eatkinso/bike-anti-theft-device/Firmware/ST/STM32Cube_FW_WL_V1.1.0/Projects/NUCLEO-WL55JC/Templates/DualCore/readme.txt

/**
  @page Templates  Description of the Templates example
  
  @verbatim
  ******************************************************************************
  * @file    Templates/DualCore/readme.txt 
  * @author  MCD Application Team
  * @brief   Description of the Templates example.
  ******************************************************************************
  *
  * Copyright (c) 2020 STMicroelectronics. All rights reserved.
  *
  * This software component is licensed by ST under BSD 3-Clause license,
  * the "License"; You may not use this file except in compliance with the
  * License. You may obtain a copy of the License at:
  *                       opensource.org/licenses/BSD-3-Clause
  *
  ******************************************************************************
  @endverbatim

@par Example Description

This projects provides a reference template that can be used to build any Dual Core (CM4 / CM0) firmware application.

This directory provides a reference template project that can be used to build any firmware application for
STM32WL55JCxx devices using STM32CubeWL HAL and running on NUCLEO-WL55JC board from STMicroelectronics. 

@note Care must be taken when using HAL_Delay(), this function provides accurate delay (in milliseconds)
      based on variable incremented in SysTick ISR. This implies that if HAL_Delay() is called from
      a peripheral ISR process, then the SysTick interrupt must have higher priority (numerically lower)
      than the peripheral interrupt. Otherwise the caller ISR process will be blocked.
      To change the SysTick interrupt priority you have to use HAL_NVIC_SetPriority() function.
      
@note The application needs to ensure that the SysTick time base is always set to 1 millisecond
      to have correct HAL operation.

@par Directory contents 

  - Templates/DualCore/Src/main.c                 Main program
  - Templates/DualCore/Src/system_stm32wlxx.c     STM32WLxx system clock configuration file
  - Templates/DualCore/Src/stm32wlxx_it.c         Interrupt handlers 
  - Templates/DualCore/Src/stm32wlxx_hal_msp.c    HAL MSP module
  - Templates/DualCore/Inc/main.h                 Main program header file  
  - Templates/DualCore/Inc/stm32wlxx_hal_conf.h   HAL Configuration file
  - Templates/DualCore/Inc/stm32wlxx_it.h         Interrupt handlers header file

@par Hardware and Software environment

  - This example runs on STM32WL55JCxx devices.
    
  - This example has been tested with STMicroelectronics NUCLEO-WL55JC
    boards and can be easily tailored to any other supported device 
    and development board.

@par How to use it ? 

In order to make the program work, you must do the following :
 - Open your preferred toolchain
 - Rebuild all files and load your image into target memory
 - Run the example

 * <h3><center>&copy; COPYRIGHT STMicroelectronics</center></h3>
 */
