eatkinso/bike-anti-theft-device/Firmware/ST/STM32Cube_FW_WL_V1.1.0/Projects/NUCLEO-WL55JC/Applications/LoRaWAN_FUOTA_DualCore/LoRaWAN_End_Node_DualCore/readme.txt

/**
  @page LoRaWAN_End_Node_DualCore Readme file

  @verbatim
  ******************** (C) COPYRIGHT 2020 STMicroelectronics *******************
  * @file    Applications/LoRaWAN_FUOTA_DualCore/LoRaWAN_End_Node_DualCore/readme.txt
  * @author  MCD Application Team
  * @brief   This application is a simple demo application software of a LoRa
  *          modem connecting to Network server. with firmware update over the air download capabilities
  ******************************************************************************
  * @attention
  *
  * <h2><center>&copy; Copyright (c) 2020 STMicroelectronics.
  * All rights reserved.</center></h2>
  *
  * This software component is licensed by ST under Ultimate Liberty license
  * SLA0044, the "License"; You may not use this file except in compliance with
  * the License. You may obtain a copy of the License at:
  *                             www.st.com/SLA0044
  *
  ******************************************************************************
  @endverbatim

@par Description

This directory contains a set of source files that implements a Dual Core (CM4 / CM0) LoRa application
device with firmware update over the air download capabilities.

For more details, refer to AN5554 "LoRaWAN firmware update over the air with STM32CubeWL" available from
the STMicroelectronics microcontroller website www.st.com.

This application is targeting the STM32WLxx Nucleo board embedding the STM32WLxx.
  ******************************************************************************

@par Keywords

Applications, SubGHz_Phy, LoRaWAN, End_Node, DualCore, FUOTA, SBSFU, KMS

@par Directory contents

  - LoRaWAN_End_Node_DualCore/CM0PLUS/Core/Inc/cmsis_nvic_virtual.h             Maps the NVIC functions on _SVC for Unpriviledge usage
  - LoRaWAN_End_Node_DualCore/CM0PLUS/Core/Inc/flash_if.h                       This file contains definitions for FLASH Interface functionalities.
  - LoRaWAN_End_Node_DualCore/CM0PLUS/Core/Inc/ipcc.h                           This file contains all the function prototypes for
                                                                                the ipcc.c file
  - LoRaWAN_End_Node_DualCore/CM0PLUS/Core/Inc/ipcc_if.h                        This file contains the interface of the ipcc driver on CM0PLUS.
  - LoRaWAN_End_Node_DualCore/CM0PLUS/Core/Inc/kms_if.h                         This file contains kms interfaces with middleware
  - LoRaWAN_End_Node_DualCore/CM0PLUS/Core/Inc/main.h                           : Header for main.c file.
                                                                                This file contains the common defines of the application.
  - LoRaWAN_End_Node_DualCore/CM0PLUS/Core/Inc/platform.h                       Header for General HW instances configuration
  - LoRaWAN_End_Node_DualCore/CM0PLUS/Core/Inc/rtc.h                            This file contains all the function prototypes for
                                                                                the rtc.c file
  - LoRaWAN_End_Node_DualCore/CM0PLUS/Core/Inc/stm32wlxx_hal_conf.h             HAL configuration file.
  - LoRaWAN_End_Node_DualCore/CM0PLUS/Core/Inc/stm32wlxx_it.h                   This file contains the headers of the interrupt handlers.
  - LoRaWAN_End_Node_DualCore/CM0PLUS/Core/Inc/stm32_lpm_if.h                   Header for Low Power Manager interface configuration
  - LoRaWAN_End_Node_DualCore/CM0PLUS/Core/Inc/subghz.h                         This file contains all the function prototypes for
                                                                                the subghz.c file
  - LoRaWAN_End_Node_DualCore/CM0PLUS/Core/Inc/sys_app.h                        Function prototypes for sys_app.c file
  - LoRaWAN_End_Node_DualCore/CM0PLUS/Core/Inc/sys_conf.h                       Applicative configuration, e.g. : debug, trace, low power, sensors
  - LoRaWAN_End_Node_DualCore/CM0PLUS/Core/Inc/sys_privileged_services.h        Maps sys_privileged_wrap functions on SVC and API to cortex services
  - LoRaWAN_End_Node_DualCore/CM0PLUS/Core/Inc/sys_privileged_wrap.h            This file contains all the function prototypes for
                                                                                the sys_privileged_wrap.c file
  - LoRaWAN_End_Node_DualCore/CM0PLUS/Core/Inc/timer_if.h                       configuration of the timer_if.c instances
  - LoRaWAN_End_Node_DualCore/CM0PLUS/Core/Inc/utilities_conf.h                 Header for configuration file to utilities
  - LoRaWAN_End_Node_DualCore/CM0PLUS/Core/Inc/utilities_def.h                  Definitions for modules requiring utilities
  - LoRaWAN_End_Node_DualCore/CM0PLUS/KMS/App/app_kms.h                         !!! No description found !!!
  - LoRaWAN_End_Node_DualCore/CM0PLUS/LoRaWAN/App/app_lorawan.h                 Header of application of the LRWAN Middleware
  - LoRaWAN_End_Node_DualCore/CM0PLUS/LoRaWAN/App/Commissioning.h               End-device commissioning parameters
  - LoRaWAN_End_Node_DualCore/CM0PLUS/LoRaWAN/App/fw_update_agent.h             This file provides set of functions to manage Firmware Update functionalities.
  - LoRaWAN_End_Node_DualCore/CM0PLUS/LoRaWAN/App/lora_app.h                    Header of application of the LRWAN Middleware
  - LoRaWAN_End_Node_DualCore/CM0PLUS/LoRaWAN/App/lora_app_version.h            Definition the version of the CM0PLUS application
  - LoRaWAN_End_Node_DualCore/CM0PLUS/LoRaWAN/App/se-identity.h                 Secure Element identity and keys
  - LoRaWAN_End_Node_DualCore/CM0PLUS/LoRaWAN/Target/frag_decoder_if.h          Applicative interfaces of LoRa-Alliance fragmentation decoder
  - LoRaWAN_End_Node_DualCore/CM0PLUS/LoRaWAN/Target/lorawan_conf.h             Header for LoRaWAN middleware instances
  - LoRaWAN_End_Node_DualCore/CM0PLUS/LoRaWAN/Target/mw_log_conf.h              Configure (enable/disable) traces for CM0
  - LoRaWAN_End_Node_DualCore/CM0PLUS/LoRaWAN/Target/radio_board_if.h           Header for Radio interface configuration
  - LoRaWAN_End_Node_DualCore/CM0PLUS/LoRaWAN/Target/radio_conf.h               Header of Radio configuration
  - LoRaWAN_End_Node_DualCore/CM0PLUS/LoRaWAN/Target/systime.h                  Map middleware systime
  - LoRaWAN_End_Node_DualCore/CM0PLUS/LoRaWAN/Target/timer.h                    Wrapper to timer server
  - LoRaWAN_End_Node_DualCore/CM0PLUS/MbMux/LmHandler_mbwrapper.h               This file implements the CM0PLUS side wrapper of the LmHandler
                                                                                interface shared between M0 and M4.
  - LoRaWAN_End_Node_DualCore/CM0PLUS/MbMux/mbmux.h                             API which interfaces CM0PLUS to IPCC
  - LoRaWAN_End_Node_DualCore/CM0PLUS/MbMux/mbmuxif_lora.h                      API provided to CM0PLUS application to register and handle LoraWAN via MBMUX
  - LoRaWAN_End_Node_DualCore/CM0PLUS/MbMux/mbmuxif_radio.h                     API for CM0PLUS application to register and handle RADIO driver via MBMUX
  - LoRaWAN_End_Node_DualCore/CM0PLUS/MbMux/mbmuxif_sys.h                       API for CM0PLUS application to handle the SYSTEM MBMUX channel
  - LoRaWAN_End_Node_DualCore/CM0PLUS/MbMux/mbmuxif_trace.h                     API for CM0PLUS application to register and handle TRACE via MBMUX
  - LoRaWAN_End_Node_DualCore/CM0PLUS/MbMux/radio_mbwrapper.h                   This file implements the CM0PLUS side wrapper of the Radio interface
                                                                                shared between M0 and M4.
  - LoRaWAN_End_Node_DualCore/CM4/Core/Inc/adc.h                                This file contains all the function prototypes for
                                                                                the adc.c file
  - LoRaWAN_End_Node_DualCore/CM4/Core/Inc/adc_if.h                             Header for ADC interface configuration
  - LoRaWAN_End_Node_DualCore/CM4/Core/Inc/dma.h                                This file contains all the function prototypes for
                                                                                the dma.c file
  - LoRaWAN_End_Node_DualCore/CM4/Core/Inc/ipcc.h                               This file contains all the function prototypes for
                                                                                the ipcc.c file
  - LoRaWAN_End_Node_DualCore/CM4/Core/Inc/ipcc_if.h                            This file contains the interface of the ipcc driver on CM4.
  - LoRaWAN_End_Node_DualCore/CM4/Core/Inc/main.h                               : Header for main.c file.
                                                                                This file contains the common defines of the application.
  - LoRaWAN_End_Node_DualCore/CM4/Core/Inc/platform.h                           Header for General HW instances configuration
  - LoRaWAN_End_Node_DualCore/CM4/Core/Inc/stm32wlxx_hal_conf.h                 HAL configuration file.
  - LoRaWAN_End_Node_DualCore/CM4/Core/Inc/stm32wlxx_it.h                       This file contains the headers of the interrupt handlers.
  - LoRaWAN_End_Node_DualCore/CM4/Core/Inc/stm32_lpm_if.h                       Header for Low Power Manager interface configuration
  - LoRaWAN_End_Node_DualCore/CM4/Core/Inc/sys_app.h                            Function prototypes for sys_app.c file
  - LoRaWAN_End_Node_DualCore/CM4/Core/Inc/sys_conf.h                           Applicative configuration, e.g. : debug, trace, low power, sensors
  - LoRaWAN_End_Node_DualCore/CM4/Core/Inc/sys_sensors.h                        Header for sensors application
  - LoRaWAN_End_Node_DualCore/CM4/Core/Inc/timer_if.h                           configuration of the timer_if.c instances
  - LoRaWAN_End_Node_DualCore/CM4/Core/Inc/usart.h                              This file contains all the function prototypes for
                                                                                the usart.c file
  - LoRaWAN_End_Node_DualCore/CM4/Core/Inc/usart_if.h                           Header for USART interface configuration
  - LoRaWAN_End_Node_DualCore/CM4/Core/Inc/utilities_conf.h                     Header for configuration file to utilities
  - LoRaWAN_End_Node_DualCore/CM4/Core/Inc/utilities_def.h                      Definitions for modules requiring utilities
  - LoRaWAN_End_Node_DualCore/CM4/LoRaWAN/App/app_lorawan.h                     Header of application of the LRWAN Middleware
  - LoRaWAN_End_Node_DualCore/CM4/LoRaWAN/App/CayenneLpp.h                      Implements the Cayenne Low Power Protocol
  - LoRaWAN_End_Node_DualCore/CM4/LoRaWAN/App/lora_app.h                        Header of application of the LRWAN Middleware
  - LoRaWAN_End_Node_DualCore/CM4/LoRaWAN/App/lora_app_version.h                Definition the version of the CM4 application
  - LoRaWAN_End_Node_DualCore/CM4/LoRaWAN/Target/lorawan_conf.h                 Header for LoRaWAN middleware instances
  - LoRaWAN_End_Node_DualCore/CM4/LoRaWAN/Target/systime.h                      Map middleware systime
  - LoRaWAN_End_Node_DualCore/CM4/LoRaWAN/Target/timer.h                        Wrapper to timer server
  - LoRaWAN_End_Node_DualCore/CM4/MbMux/LmHandler_mbwrapper.h                   This file implements the CM4 side wrapper of the LmHandler
                                                                                interface shared between M0 and M4.
  - LoRaWAN_End_Node_DualCore/CM4/MbMux/mbmux.h                                 API which interfaces CM4 to IPCC
  - LoRaWAN_End_Node_DualCore/CM4/MbMux/mbmuxif_lora.h                          API provided to CM4 application to register and handle LoraWAN via MBMUX
  - LoRaWAN_End_Node_DualCore/CM4/MbMux/mbmuxif_radio.h                         API for CM4 application to register and handle RADIO driver via MBMUX
  - LoRaWAN_End_Node_DualCore/CM4/MbMux/mbmuxif_sys.h                           API for CM4 application to handle the SYSTEM MBMUX channel
  - LoRaWAN_End_Node_DualCore/CM4/MbMux/mbmuxif_trace.h                         API for CM4 application to register and handle TRACE via MBMUX
  - LoRaWAN_End_Node_DualCore/CM4/MbMux/radio_mbwrapper.h                       This file implements the CM4 side wrapper of the Radio interface
                                                                                shared between M0 and M4.
  - LoRaWAN_End_Node_DualCore/Common/Board/stm32wlxx_nucleo_conf.h              STM32WLxx_Nucleo board configuration file.
  - LoRaWAN_End_Node_DualCore/Common/MbMux/features_info.h                      Feature list and parameters TypeDefinitions
  - LoRaWAN_End_Node_DualCore/Common/MbMux/lora_info.h                          To give info to the application about LoRaWAN configuration
  - LoRaWAN_End_Node_DualCore/Common/MbMux/mbmux_table.h                        Maps the IPCC channels to memory buffers
  - LoRaWAN_End_Node_DualCore/Common/MbMux/msg_id.h                             MBMUX message ID enumeration
  - LoRaWAN_End_Node_DualCore/Common/System/sys_debug.h                         Configuration of the debug.c instances

  - LoRaWAN_End_Node_DualCore/CM0PLUS/Core/Src/flash_if.c                       This file provides set of firmware functions to manage Flash
                                                                                Interface functionalities.
  - LoRaWAN_End_Node_DualCore/CM0PLUS/Core/Src/ipcc.c                           This file provides code for the configuration
                                                                                of the IPCC instances.
  - LoRaWAN_End_Node_DualCore/CM0PLUS/Core/Src/ipcc_if.c                        Interface to IPCC: handles IRQs and abstract application from Ipcc handler and channel direction
  - LoRaWAN_End_Node_DualCore/CM0PLUS/Core/Src/main.c                           : Main program body
  - LoRaWAN_End_Node_DualCore/CM0PLUS/Core/Src/rtc.c                            This file provides code for the configuration
                                                                                of the RTC instances.
  - LoRaWAN_End_Node_DualCore/CM0PLUS/Core/Src/stm32wlxx_hal_msp.c              This file provides code for the MSP Initialization
                                                                                and de-Initialization codes.
  - LoRaWAN_End_Node_DualCore/CM0PLUS/Core/Src/stm32wlxx_it.c                   Interrupt Service Routines.
  - LoRaWAN_End_Node_DualCore/CM0PLUS/Core/Src/stm32_lpm_if.c                   Low layer function to enter/exit low power modes (stop, sleep)
  - LoRaWAN_End_Node_DualCore/CM0PLUS/Core/Src/subghz.c                         This file provides code for the configuration
                                                                                of the SUBGHZ instances.
  - LoRaWAN_End_Node_DualCore/CM0PLUS/Core/Src/sys_app.c                        Initializes HW and SW system entities (not related to the radio)
  - LoRaWAN_End_Node_DualCore/CM0PLUS/Core/Src/sys_privileged_services.c        gives access to COrtex services like ThumbState, SVC, MPU
  - LoRaWAN_End_Node_DualCore/CM0PLUS/Core/Src/sys_privileged_wrap.c            Wrapper functions to call SVC when in Unprivilege mode
  - LoRaWAN_End_Node_DualCore/CM0PLUS/Core/Src/timer_if.c                       Configure RTC Alarm, Tick and Calendar manager
  - LoRaWAN_End_Node_DualCore/CM0PLUS/KMS/App/app_kms.c                         !!! No description found !!!
  - LoRaWAN_End_Node_DualCore/CM0PLUS/LoRaWAN/App/app_lorawan.c                 Application of the LRWAN Middleware
  - LoRaWAN_End_Node_DualCore/CM0PLUS/LoRaWAN/App/fw_update_agent.c             This file provides set of functions to manage Firmware Update functionalities.
  - LoRaWAN_End_Node_DualCore/CM0PLUS/LoRaWAN/App/lora_app.c                    Application of the LRWAN Middleware
  - LoRaWAN_End_Node_DualCore/CM0PLUS/LoRaWAN/Target/frag_decoder_if.c          Implements the Data Distribution Agent
  - LoRaWAN_End_Node_DualCore/CM0PLUS/LoRaWAN/Target/radio_board_if.c           This file provides an interface layer between MW and Radio Board
  - LoRaWAN_End_Node_DualCore/CM0PLUS/MbMux/features_info.c                     CM0PLUS supported features list
  - LoRaWAN_End_Node_DualCore/CM0PLUS/MbMux/LmHandler_mbwrapper.c               This file implements the CM0PLUS side wrapper of the LoraMac interface
                                                                                shared between M0 and M4.
  - LoRaWAN_End_Node_DualCore/CM0PLUS/MbMux/lora_info.c                         To give info to the application about LoRaWAN configuration
  - LoRaWAN_End_Node_DualCore/CM0PLUS/MbMux/mbmux.c                             Interface CPU2 to IPCC: multiplexer to map features to IPCC channels
  - LoRaWAN_End_Node_DualCore/CM0PLUS/MbMux/mbmuxif_lora.c                      allows CM0 application to register and handle LoraWAN to MBMUX
  - LoRaWAN_End_Node_DualCore/CM0PLUS/MbMux/mbmuxif_radio.c                     allows CM0PLUS application to register and handle RADIO driver via MBMUX
  - LoRaWAN_End_Node_DualCore/CM0PLUS/MbMux/mbmuxif_sys.c                       allows CM0 application to handle the SYSTEM MBMUX channel
  - LoRaWAN_End_Node_DualCore/CM0PLUS/MbMux/mbmuxif_trace.c                     Interface layer CM0PLUS Trace to MBMUX (Mailbox Multiplexer)
  - LoRaWAN_End_Node_DualCore/CM0PLUS/MbMux/radio_mbwrapper.c                   This file implements the CM0 side wrapper of the Radio interface
                                                                                shared between M0 and M4.
  - LoRaWAN_End_Node_DualCore/CM4/Core/Src/adc.c                                This file provides code for the configuration
                                                                                of the ADC instances.
  - LoRaWAN_End_Node_DualCore/CM4/Core/Src/adc_if.c                             Read status related to the chip (battery level, VREF, chip temperature)
  - LoRaWAN_End_Node_DualCore/CM4/Core/Src/dma.c                                This file provides code for the configuration
                                                                                of all the requested memory to memory DMA transfers.
  - LoRaWAN_End_Node_DualCore/CM4/Core/Src/ipcc.c                               This file provides code for the configuration
                                                                                of the IPCC instances.
  - LoRaWAN_End_Node_DualCore/CM4/Core/Src/ipcc_if.c                            Interface to IPCC: handles IRQs and abstract application from Ipcc handler and channel direction
  - LoRaWAN_End_Node_DualCore/CM4/Core/Src/main.c                               : Main program body
  - LoRaWAN_End_Node_DualCore/CM4/Core/Src/stm32wlxx_hal_msp.c                  This file provides code for the MSP Initialization
                                                                                and de-Initialization codes.
  - LoRaWAN_End_Node_DualCore/CM4/Core/Src/stm32wlxx_it.c                       Interrupt Service Routines.
  - LoRaWAN_End_Node_DualCore/CM4/Core/Src/stm32_lpm_if.c                       Low layer function to enter/exit low power modes (stop, sleep)
  - LoRaWAN_End_Node_DualCore/CM4/Core/Src/sys_app.c                            Initializes HW and SW system entities (not related to the radio)
  - LoRaWAN_End_Node_DualCore/CM4/Core/Src/sys_sensors.c                        Manages the sensors on the application
  - LoRaWAN_End_Node_DualCore/CM4/Core/Src/timer_if.c                           Configure RTC Alarm, Tick and Calendar manager
  - LoRaWAN_End_Node_DualCore/CM4/Core/Src/usart.c                              This file provides code for the configuration
                                                                                of the USART instances.
  - LoRaWAN_End_Node_DualCore/CM4/Core/Src/usart_if.c                           Configuration of UART driver interface for hyperterminal communication
  - LoRaWAN_End_Node_DualCore/CM4/LoRaWAN/App/app_lorawan.c                     Application of the LRWAN Middleware
  - LoRaWAN_End_Node_DualCore/CM4/LoRaWAN/App/CayenneLpp.c                      Implements the Cayenne Low Power Protocol
  - LoRaWAN_End_Node_DualCore/CM4/LoRaWAN/App/lora_app.c                        Application of the LRWAN Middleware
  - LoRaWAN_End_Node_DualCore/CM4/MbMux/LmHandler_mbwrapper.c                   This file implements the CM4 side wrapper of the LoraMac interface
                                                                                shared between M0 and M4.
  - LoRaWAN_End_Node_DualCore/CM4/MbMux/mbmux.c                                 CM4 side multiplexer to map features to IPCC channels
  - LoRaWAN_End_Node_DualCore/CM4/MbMux/mbmuxif_lora.c                          allows CM4 application to register and handle LoraWAN via MBMUX
  - LoRaWAN_End_Node_DualCore/CM4/MbMux/mbmuxif_radio.c                         allows CM4 application to register and handle RADIO driver via MBMUX
  - LoRaWAN_End_Node_DualCore/CM4/MbMux/mbmuxif_sys.c                           allows CM4 application to handle the SYSTEM MBMUX channel.
  - LoRaWAN_End_Node_DualCore/CM4/MbMux/mbmuxif_trace.c                         allows CM4 application to receive by CM0 TRACE via MBMUX
  - LoRaWAN_End_Node_DualCore/CM4/MbMux/radio_mbwrapper.c                       This file implements the CM4 side wrapper of the Radio interface
                                                                                shared between M0 and M4.
  - LoRaWAN_End_Node_DualCore/Common/System/system_stm32wlxx.c                  CMSIS Cortex Device Peripheral Access Layer System Source File
  - LoRaWAN_End_Node_DualCore/Common/System/sys_debug.c                         Enables 4 debug pins for internal signals RealTime debugging
  - LoRaWAN_End_Node_DualCore/STM32CubeIDE/CM0PLUS/Application/User/Core/syscalls.cSTM32CubeIDE Minimal System calls file
  - LoRaWAN_End_Node_DualCore/STM32CubeIDE/CM0PLUS/Application/User/Core/sysmem.cSTM32CubeIDE System Memory calls file
  - LoRaWAN_End_Node_DualCore/STM32CubeIDE/CM4/Application/User/Core/syscalls.c STM32CubeIDE Minimal System calls file
  - LoRaWAN_End_Node_DualCore/STM32CubeIDE/CM4/Application/User/Core/sysmem.c   STM32CubeIDE System Memory calls file

@par Hardware and Software environment

  - This example runs on the STM32WLxx Nucleo board.

  - STM32WLxx Nucleo board Set-up
    - Connect the Nucleo board to your PC with a USB cable type A to micro-B
      to ST-LINK connector.
    - Please ensure that the ST-LINK connector jumpers are fitted.

  - Configure the software via the configuration files:
    - CM0PLUS (Mw and radio drivers config)
        - sys_conf.h, radio_conf.h, lorawan_conf.h, Commissioning.h, se-identity.h, mw_log_conf.h, main.h, etc
    - CM4 (Lora application)
        - sys_conf.h, lora_app.h, nucleo_conf.h, main.h, etc
    - Careful:
        - the region and class chosen on CM4/LoRaWAN/App/lora_app.h shall be compatible with CM0PLUS/LoRaWAN/Target/lorawan_conf.h list

  -Set Up:

             --------------------------  V    V  --------------------------
             |      LoRa Object       |  |    |  |      LoRa Network      |
             |                        |  |    |  |                        |
   ComPort<--|                        |--|    |--|                        |-->Web Server
             |                        |          |                        |
             --------------------------          --------------------------

@par How to use it ?
In order to make the program work, you must do the following :
  - use the script \Scripts\<MyPreferredToolchain>\build.bat to rebuild the SBSFU and the LoRaWAN projects
  - use the script \Scripts\<MyPreferredToolchain>\program.bat to download the big binary on target device
  - Reset the system (two cores)
  - Run the example
  - Open a Terminal, connected the LoRa Object
  - UART Config = 115200, 8b, 1 stopbit, no parity, no flow control

@par How to debug ?
  - change or undefine following definitions in above files:
    - in ..\2_Images_SBSFU\CM0PLUS\app_sfu.h
      /*#define SFU_RDP_PROTECT_ENABLE*/
      /*#define SFU_C2SWDBG_PROTECT_ENABLE*/
    - in ..\2_Images_SBSFU\Common\app_sfu_common.h
      /*#define SFU_DAP_PROTECT_ENABLE*/
      /*#define SFU_C2_DDS_PROTECT_ENABLE*/
      #define SFU_HIDE_PROTECTION_CFG OB_SECURE_HIDE_PROTECTION_DISABLE
    - in .\LoRaWAN_End_Node_DualCore\CM4\Core\Inc\sys_conf.h
      #define DEBUGGER_ENABLED   1   to debug CM4
      #define LOW_POWER_DISABLE   1  at least on one MCU (CM4 or CM0PUS)
    - in .\LoRaWAN_End_Node_DualCore\CM0PLUS\Core\Inc\sys_conf.h
      #define DEBUGGER_ENABLED   1   to debug CM0PLUS
      #define LOW_POWER_DISABLE   1  at least on one MCU (CM4 or CM0PUS)
  - use the script \Scripts\<MyPreferredToolchain>\build.bat to rebuild the SBSFU and the LoRaWAN projects
  - use the script \Scripts\<MyPreferredToolchain>\program.bat to download the big binary on target device
  - unplug the USB and plug it back to reconnect the board to the PC
  - SBSFU run first then LoRaWAN_End_Node starts
  - LoRaWAN_End_Node CM4 code enters in while(1) loop waiting the push button BUTTON_SW2 to be pressed
  - the CM0PLUS code is in while(1) loop waiting the CM4 to set CPUS_BOOT_SYNC_ALLOW_CPU2_TO_START
  - if you need to debug CM4 open your preferred toolchain and select CM4 project and attach to running target
  - if you need to debug CM0PLUS open your preferred toolchain and select CM0PLUS project and attach to running target
  - set the breakpoints either in CM4 or CM0PLUS or both debugger instances
  - press the push button BUTTON_SW2:
     - CM4 exits its while(1) loop and executes MBMUXIF_SetCpusSynchroFlag(1) and reaches the CM4 breakpoint
     - this allows CM0PLUS to exit its while(1) loop and to reach the CM0PLUS breakpoint

 * <h3><center>&copy; COPYRIGHT STMicroelectronics</center></h3>
 */
