eatkinso/bike-anti-theft-device/Firmware/ST/STM32Cube_FW_WL_V1.1.0/Projects/NUCLEO-WL55JC/Examples/CORTEX/CORTEXM_ModePrivilege/readme.txt

    /**
  @page CORTEXM_ModePrivilege Cortex-M4 Mode Privilege example

  @verbatim
  ******************************************************************************
  * @file    CORTEX/CORTEXM_ModePrivilege/readme.txt
  * @author  MCD Application Team
  * @brief   Description of the Cortex-M4 Mode Privilege example.
  ******************************************************************************
  *
  * Copyright (c) 2020 STMicroelectronics. All rights reserved.
  *
  * This software component is licensed by ST under BSD 3-Clause license,
  * the "License"; You may not use this file except in compliance with the
  * License. You may obtain a copy of the License at:
  *                       opensource.org/licenses/BSD-3-Clause
  *
  ******************************************************************************
  @endverbatim

@par Example Description 

How to modify the Thread mode privilege access and stack. Thread mode is entered
on reset or when returning from an exception.

The associated program is used to:

1. Switch the Thread mode stack from Main stack to Process stack

2. Switch the Thread mode from Privileged to Unprivileged

3. Switch the Thread mode from Unprivileged back to Privileged

To monitor the stack used and the privileged or unprivileged access level of code
in Thread mode, a set of variables is available within the program. It is also
possible to use the 'Cortex register' window of the debugger.

LED2 Turns ON when the test is finished successfully.

@note Care must be taken when using HAL_Delay(), this function provides accurate delay (in milliseconds)
      based on variable incremented in SysTick ISR. This implies that if HAL_Delay() is called from
      a peripheral ISR process, then the SysTick interrupt must have higher priority (numerically lower)
      than the peripheral interrupt. Otherwise the caller ISR process will be blocked.
      To change the SysTick interrupt priority you have to use HAL_NVIC_SetPriority() function.
      
@note The application need to ensure that the SysTick time base is always set to 1 millisecond
      to have correct HAL operation.

@par Keywords

System, Cortex, Mode Privilege, Privileged access, thread mode, main stack, process stack

@par Directory contents 

  - CORTEX/CORTEXM_ModePrivilege/Inc/stm32wlxx_nucleo_conf.h     BSP configuration file
  - CORTEX/CORTEXM_ModePrivilege/Inc/stm32wlxx_hal_conf.h    HAL configuration file
  - CORTEX/CORTEXM_ModePrivilege/Inc/stm32wlxx_it.h          Interrupt handlers header file
  - CORTEX/CORTEXM_ModePrivilege/Inc/main.h                  Header for main.c module
  - CORTEX/CORTEXM_ModePrivilege/Src/stm32wlxx_it.c          Interrupt handlers
  - CORTEX/CORTEXM_ModePrivilege/Src//stm32wlxx_hal_msp.c     HAL MSP file
  - CORTEX/CORTEXM_ModePrivilege/Src/main.c                  Main program
  - CORTEX/CORTEXM_ModePrivilege/Src/system_stm32wlxx.c      STM32WLxx system source file

@par Hardware and Software environment

  - This example runs on STM32WL55JCIx devices.
    
  - This example has been tested with NUCLEO-WL55JC RevC board and can be
    easily tailored to any other supported device and development board.      

@par How to use it ? 
In order to make the program work, you must do the following :
- Open your preferred toolchain 
- Rebuild all files and load your image into target memory
- Run the example

 * <h3><center>&copy; COPYRIGHT STMicroelectronics</center></h3>
 */
