eatkinso/bike-anti-theft-device/Firmware/ST/STM32Cube_FW_WL_V1.1.0/Projects/NUCLEO-WL55JC/Examples/CRYP/CRYP_AESModes/readme.txt

/**
  @page CRYP_AESModes  Encrypt and Decrypt data using AES Algo in ECB/CBC/CTR
  chaining modes with all possible key sizes.
  
  @verbatim
  ******************************************************************************
  * @file    CRYP/CRYP_AESModes/readme.txt 
  * @author  MCD Application Team
  * @brief   Description of the CRYP AES Algorithm in all modes and all key sizes
             Example
  ******************************************************************************
  *
  * Copyright (c) 2020 STMicroelectronics. All rights reserved.
  *
  * This software component is licensed by ST under BSD 3-Clause license,
  * the "License"; You may not use this file except in compliance with the
  * License. You may obtain a copy of the License at:
  *                       opensource.org/licenses/BSD-3-Clause
  *
  ******************************************************************************
  @endverbatim

@par Example Description 

How to use the CRYP peripheral to encrypt and decrypt data using AES in chaining
modes (ECB, CBC, CTR).

In this example, the following key sizes are used: 128 or 256.

For this example, a firmware is used to interface with the Crypto peripheral
in polling mode.

This example behaves as follows:

1. ECB mode:
   - AES128 ECB encryption
   - AES256 ECB encryption
   - AES128 ECB decryption
   - AES256 ECB decryption
2. CBC mode:
   - AES128 CBC encryption
   - AES256 CBC encryption
   - AES128 CBC decryption
   - AES256 CBC decryption
3. CTR mode:
   - AES128 CTR encryption
   - AES256 CTR encryption
   - AES128 CTR decryption
   - AES256 CTR decryption

When resorting to IAR Embedded Workbench IDE, AES algorithms processing status
are displayed on debugger Terminal I/O as follows: View --> Terminal I/O.
When resorting to MDK-ARM KEIL IDE, AES algorithms processing status 
are displayed on debugger as follows:  View --> Serial Viewer --> Debug (printf) Viewer.
The following hardware modifications are required to display the data on debugger for MDK-ARM :
    - The solder bridge : SB8 should be closed
    - The solder bridge : SB31 should be opened
When resorting to STM32CubeIDE:
Command Code is displayed on debugger as follows: Window--> Show View--> Console.
In Debug configuration : 
- Window\Debugger, select the Debug probe : ST-LINK(OpenOCD)
- window\ Startup,add the command "monitor arm semihosting enable"

Results can be displayed on PC (through HyperTerminal or TeraTerm) by Virtual Com Port
in enabling USE_VCP_CONNECTION compilation switch and with the proper configuration
(115200 bauds, 8 bits data, 1 stop bit, no parity, no HW flow control).

When all ciphering and deciphering operations are successful, LED1 is turned on.
In case of ciphering or deciphering issue, LED3 is turned on. 

@par Keywords

Security, Cryptography, CRYPT, AES, ECB, CBC, CTR, MAC, USART

@par Directory contents 

  - CRYP/CRYP_AESModes/Inc/stm32wlxx_nucleo_conf.h     BSP configuration file
  - CRYP/CRYP_AESModes/Inc/stm32wlxx_hal_conf.h    HAL configuration file
  - CRYP/CRYP_AESModes/Inc/stm32wlxx_it.h          Interrupt handlers header file
  - CRYP/CRYP_AESModes/Inc/main.h                  Header for main.c module  
  - CRYP/CRYP_AESModes/Src/stm32wlxx_it.c          Interrupt handlers
  - CRYP/CRYP_AESModes/Src/main.c                  Main program
  - CRYP/CRYP_AESModes/Src/stm32wlxx_hal_msp.c     HAL MSP module
  - CRYP/CRYP_AESModes/Src/system_stm32wlxx.c      STM32WLxx system source file

@par Hardware and Software environment

@par How to use it ? 

In order to make the program work, you must do the following:
 - Open your preferred toolchain 
 - Rebuild all files and load your image into target memory
 - Run the example

 * <h3><center>&copy; COPYRIGHT STMicroelectronics</center></h3>
 */
