eatkinso/bike-anti-theft-device/Firmware/ST/STM32Cube_FW_WL_V1.1.0/Projects/NUCLEO-WL55JC/Examples/HAL/HAL_TimeBase/readme.txt

/**
  @page HAL_TimeBase HAL Time base example
  
  @verbatim
  ******************************************************************************
  * @file    HAL/HAL_TimeBase/readme.txt 
  * @author  MCD Application Team
  * @brief   Description of the HAL time base example.
  ******************************************************************************
  *
  * Copyright (c) 2020 STMicroelectronics. All rights reserved.
  *
  * This software component is licensed by ST under BSD 3-Clause license,
  * the "License"; You may not use this file except in compliance with the
  * License. You may obtain a copy of the License at:
  *                       opensource.org/licenses/BSD-3-Clause
  *
  ******************************************************************************
  @endverbatim

@par Example Description 

How to customize HAL using a general-purpose timer as main source of time base, 
instead of Systick.

In this example the used timer is TIM2.

Time base duration is kept unchanged: 1ms  since PPP_TIMEOUT_VALUEs are defined 
and handled in milliseconds basis.

The example brings, in user file, a new implementation of the following HAL weak functions:

HAL_InitTick() 
HAL_SuspendTick()
HAL_ResumeTick()

This implementation will overwrite native implementation from stm32wlxx_hal.c
and so user functions will be invoked instead when called.

The following time base functions are kept as implemented natively:

HAL_IncTick()
HAL_Delay()
HAL_IncTick()

When user pushes the User push-button (B1), the Tick increment is suspended if it is already
enabled, else it will be resumed.
In an infinite loop, LED2 toggles spaced out over 1s delay, except when tick increment is suspended.

@note Care must be taken when using HAL_Delay(), this function provides accurate delay (in milliseconds)
      based on variable incremented in TIM2 ISR. This implies that if HAL_Delay() is called from
      a peripheral ISR process, then the TIM2 interrupt must have higher priority (numerically lower)
      than the peripheral interrupt. Otherwise the caller ISR process will be blocked.
      To change the TIM2 interrupt priority you have to use HAL_NVIC_SetPriority() function.
      
@note The application need to ensure that the TIM2 time base is always set to 1 millisecond
      to have correct HAL operation.

@par Keywords

System, TIM, Time base, HAL

@par Directory contents

  - HAL/HAL_TimeBase/Inc/stm32wlxx_nucleo_conf.h     BSP configuration file
  - HAL/HAL_TimeBase/Inc/stm32wlxx_hal_conf.h    HAL configuration file
  - HAL/HAL_TimeBase/Inc/stm32wlxx_it.h          Interrupt handlers header file
  - HAL/HAL_TimeBase/Inc/stm32wlxx.h             Header for main.c module  
  - HAL/HAL_TimeBase/Src/stm32wlxx_it.c          Interrupt handlers
  - HAL/HAL_TimeBase/Src/stm32wlxx_hal_msp.c     HAL MSP file
  - HAL/HAL_TimeBase/Src/main.c                        Main program
  - HAL/HAL_TimeBase/Src/system_stm32wlxx.c      STM32WLxx system source file

@par Hardware and Software environment

  - This example runs on STM32WL55JCIx devices
    
  - This example has been tested with STMicroelectronics NUCLEO-WL55JC RevC board and can be
    easily tailored to any other supported device and development board.      

@par How to use it ? 

In order to make the program work, you must do the following :
 - Open your preferred toolchain 
 - Rebuild all files and load your image into target memory
 - Run the example 

 * <h3><center>&copy; COPYRIGHT STMicroelectronics</center></h3>
 */
