eatkinso/bike-anti-theft-device/Firmware/ST/STM32Cube_FW_WL_V1.1.0/Projects/NUCLEO-WL55JC/Examples/HAL/HAL_TimeBase_RTC_WKUP/readme.txt

/**
  @page HAL_TimeBase_RTC_WKUP HAL TimeBase RTC WakeUp
  
  @verbatim
  ******************************************************************************
  * @file    HAL/HAL_TimeBase_RTC_WAKUP/readme.txt 
  * @author  MCD Application Team
  * @brief   Description of the HAL TimeBase RTC WakeUp example.
  ******************************************************************************
  *
  * Copyright (c) 2020 STMicroelectronics. All rights reserved.
  *
  * This software component is licensed by ST under BSD 3-Clause license,
  * the "License"; You may not use this file except in compliance with the
  * License. You may obtain a copy of the License at:
  *                       opensource.org/licenses/BSD-3-Clause
  *
  ******************************************************************************
  @endverbatim

@par Example Description
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
