eatkinso/bike-anti-theft-device/Documentation/Demo_RVtable/block_diagram_final.png

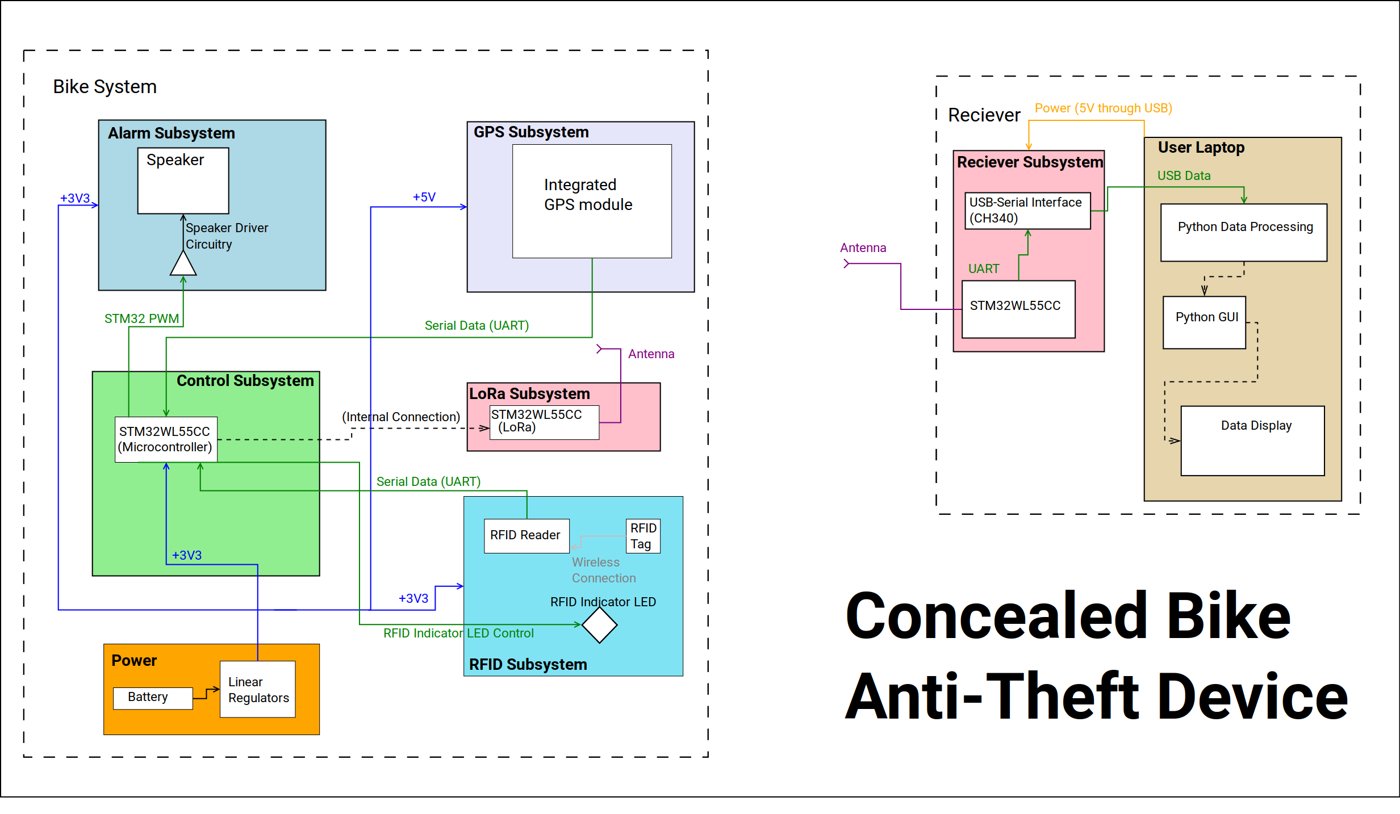
Documentation/Demo_RVtable/block_diagram_final.png
