eatkinso/bike-anti-theft-device/Documentation/Demo_RVtable/board_pic.jpeg

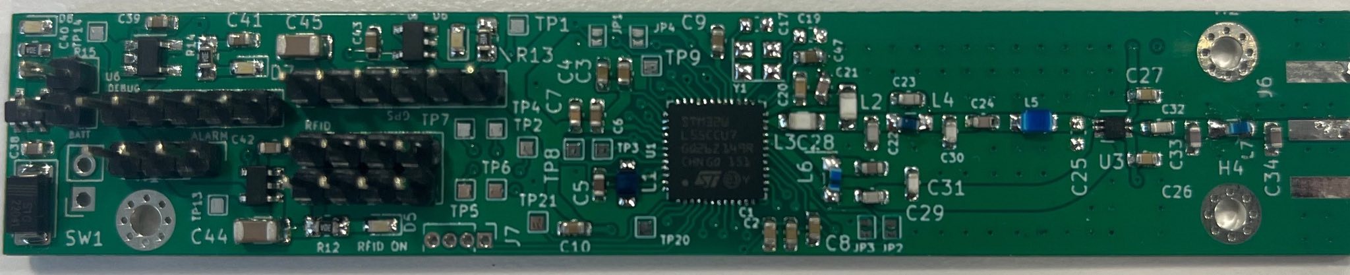
Documentation/Demo_RVtable/board_pic.jpeg
