eatkinso/bike-anti-theft-device/Documentation/Design Document/bike_reflector.jpg

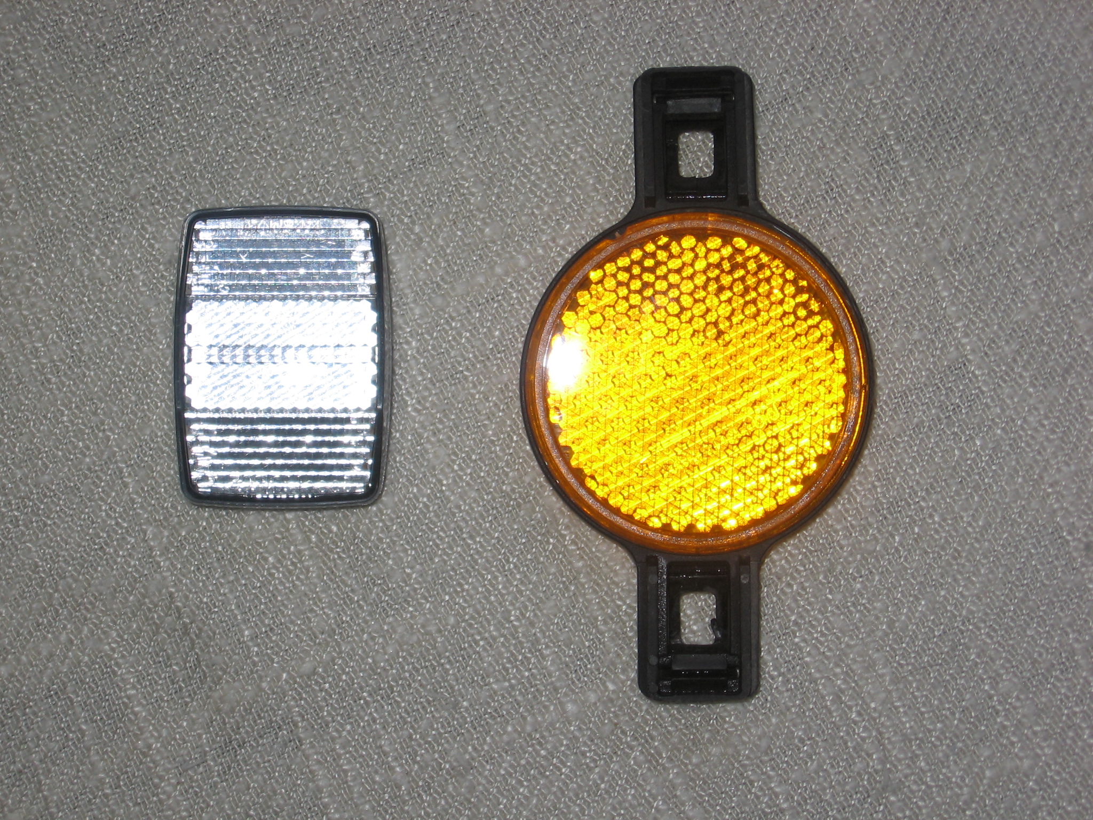
Documentation/Design Document/bike_reflector.jpg
