eatkinso/bike-anti-theft-device/Documentation/Design Document/block_diagram_full.png

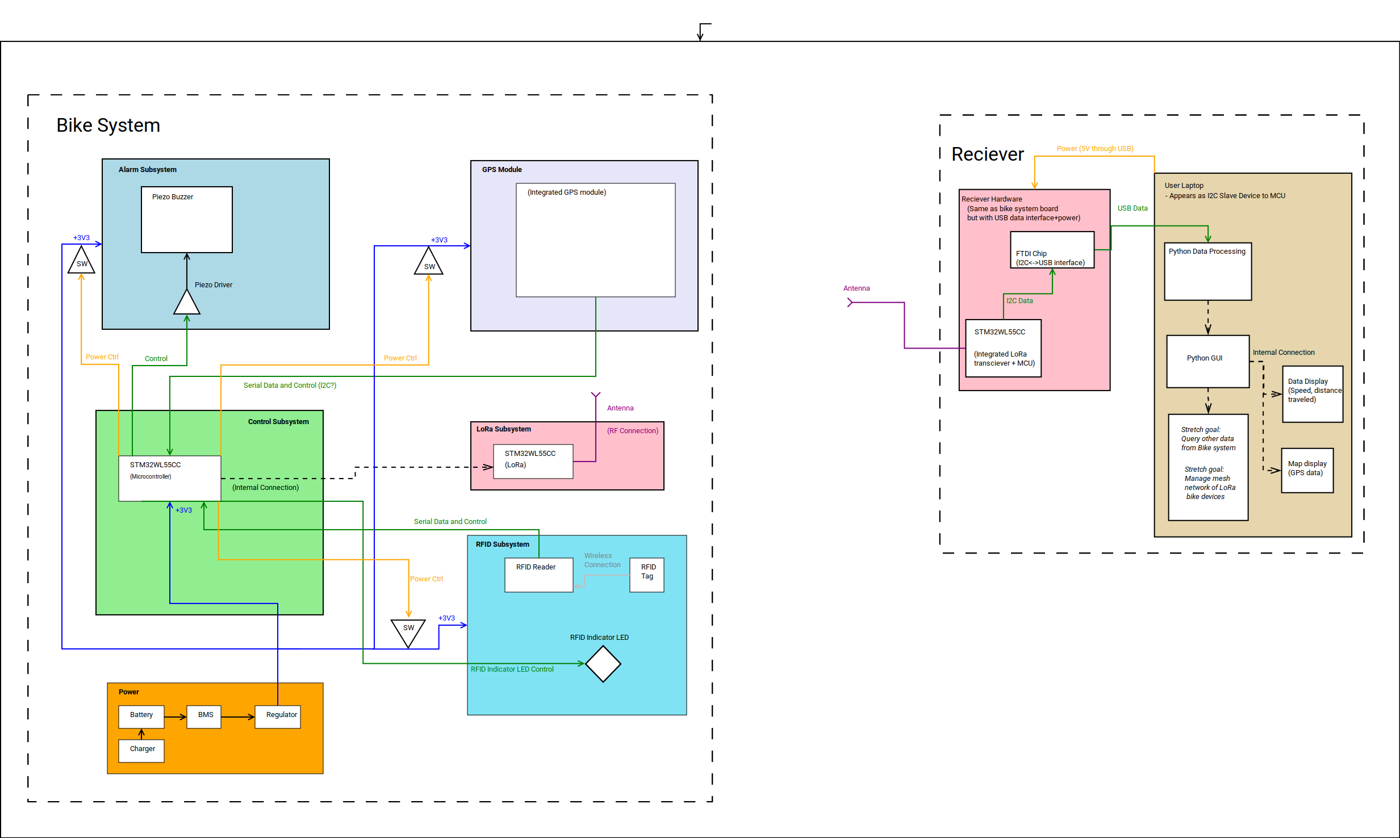
Documentation/Design Document/block_diagram_full.png
