eatkinso/bike-anti-theft-device/Documentation/Design Document/buzzer_ckt.png

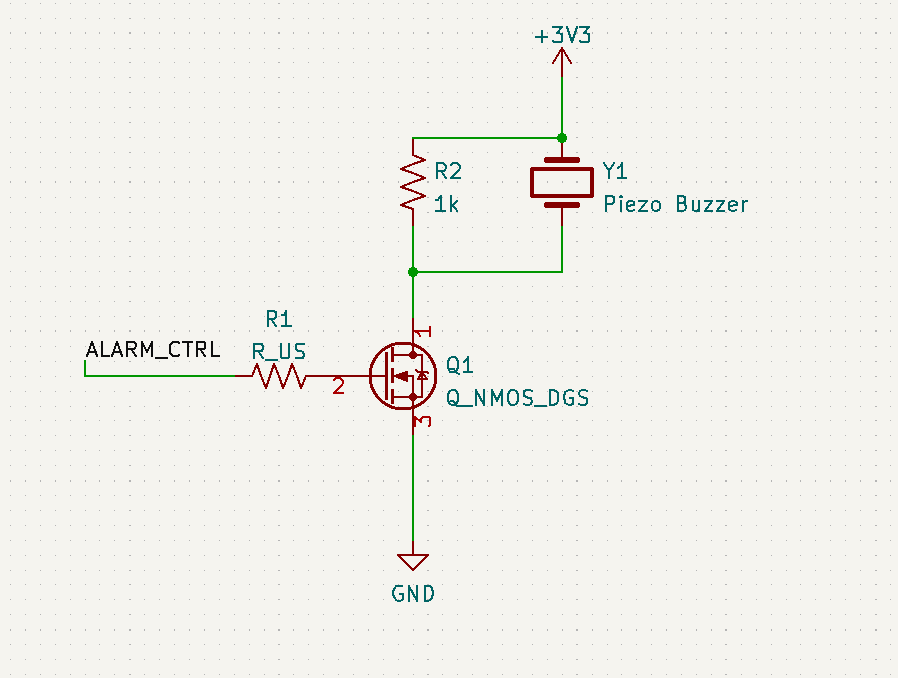
Documentation/Design Document/buzzer_ckt.png
