eatkinso/bike-anti-theft-device/Documentation/Design Document/linear_reg_diagram.png

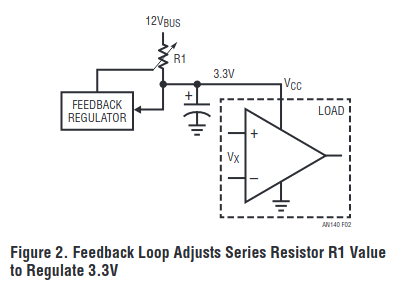
Documentation/Design Document/linear_reg_diagram.png
