eatkinso/bike-anti-theft-device/Documentation/Design Document/loadsw_sch.png

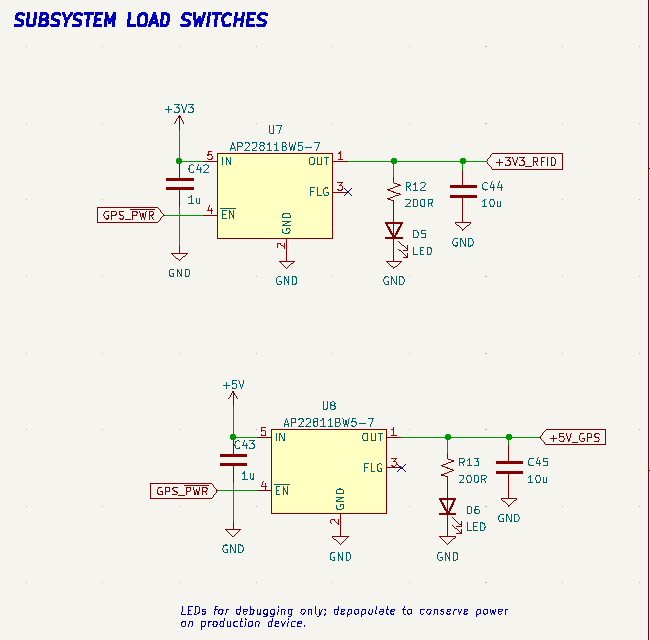
Documentation/Design Document/loadsw_sch.png
