eatkinso/bike-anti-theft-device/Documentation/Design Document/mcu_schematic.png

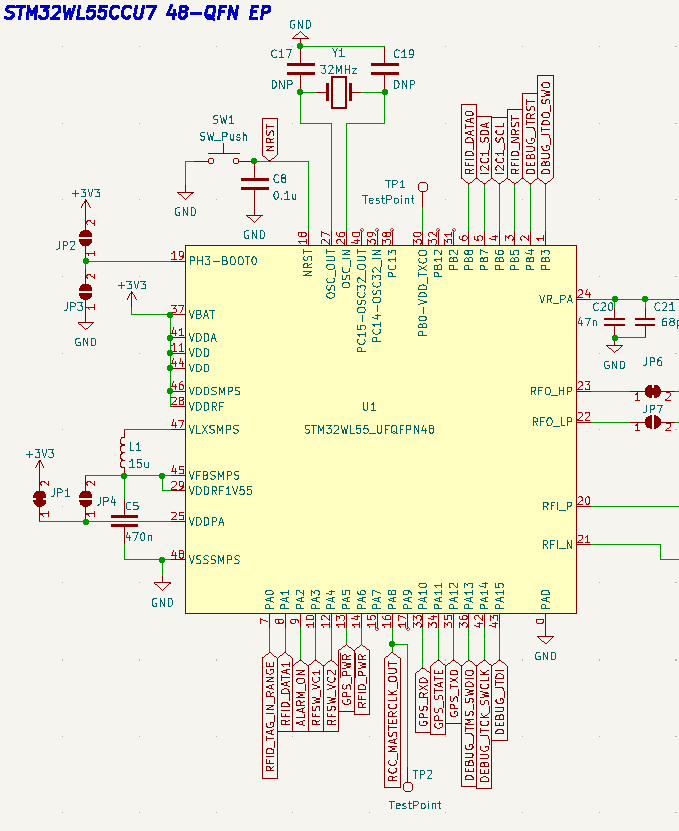
Documentation/Design Document/mcu_schematic.png
