eatkinso/bike-anti-theft-device/Documentation/Design Document/pwr_sch.png

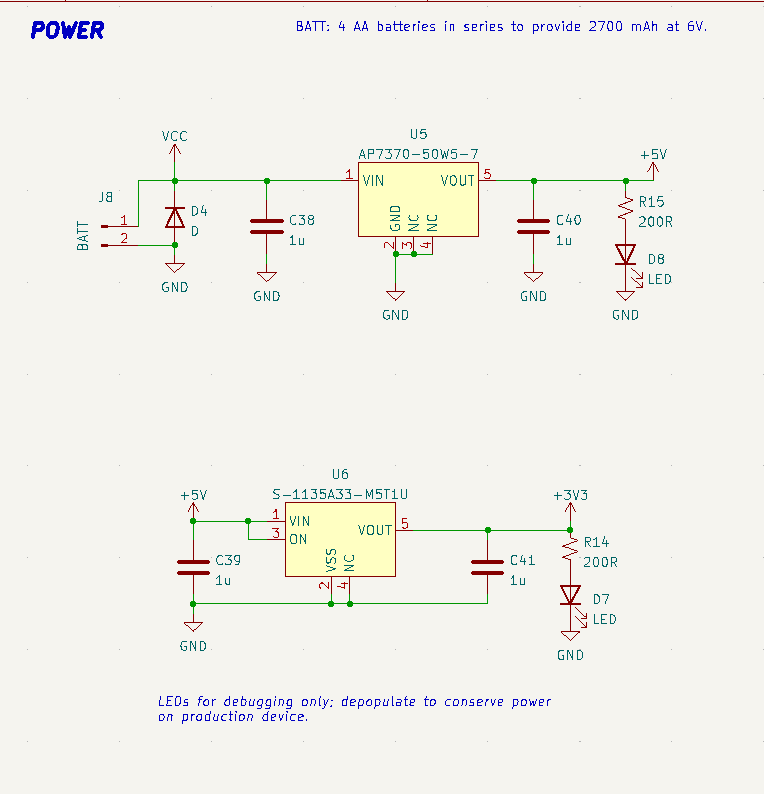
Documentation/Design Document/pwr_sch.png
