eatkinso/bike-anti-theft-device/Documentation/Design Document/rf-ckt.png

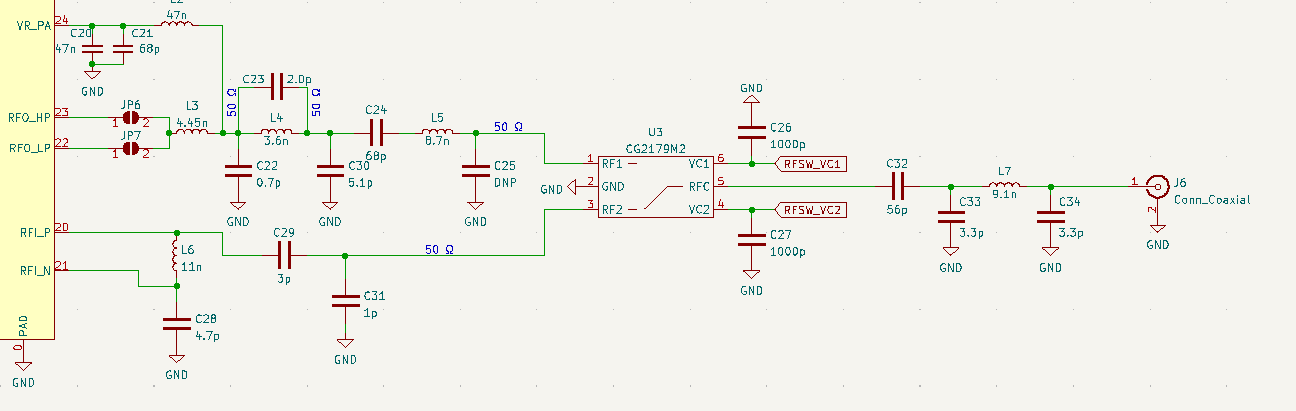
Documentation/Design Document/rf-ckt.png
