eatkinso/bike-anti-theft-device/Documentation/Design Document/rfid_sch.png

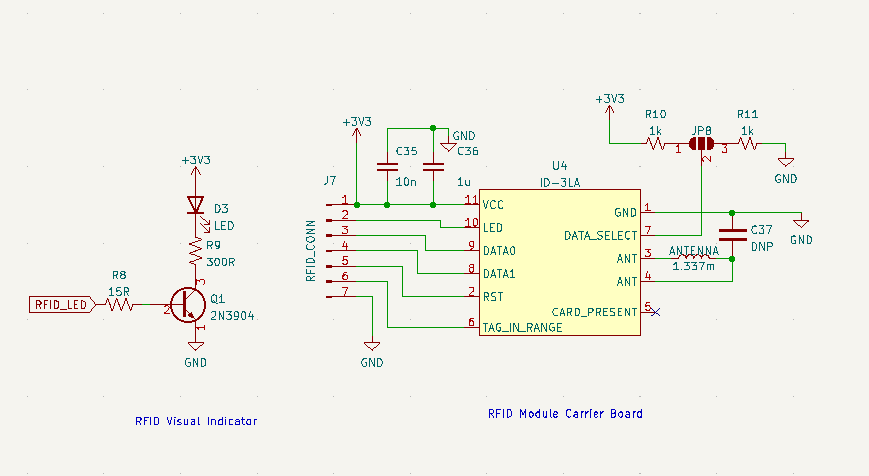
Documentation/Design Document/rfid_sch.png
