eatkinso/bike-anti-theft-device/Documentation/Design Document/usb_interface.png

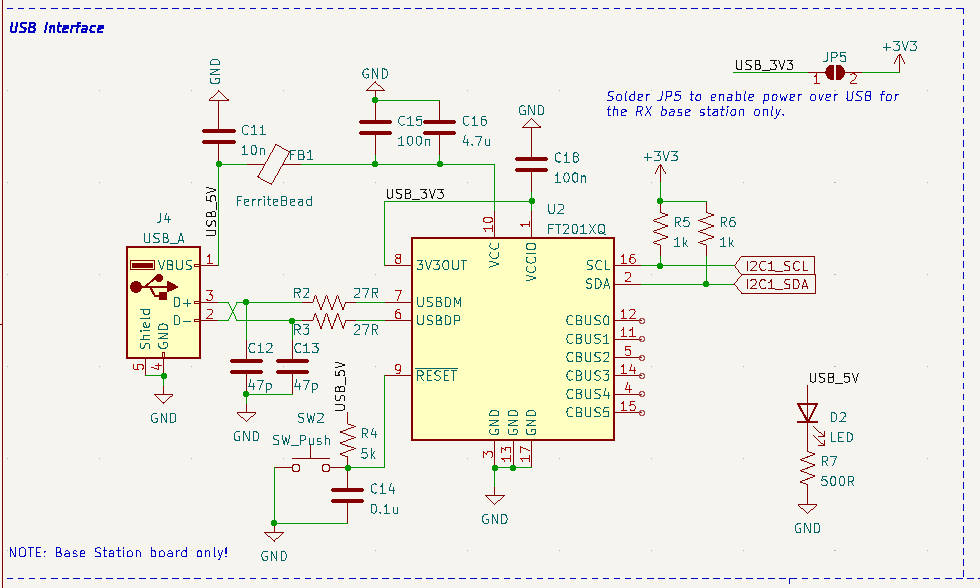
Documentation/Design Document/usb_interface.png
