eatkinso/bike-anti-theft-device/Documentation/Design Document/visual_aid.JPG

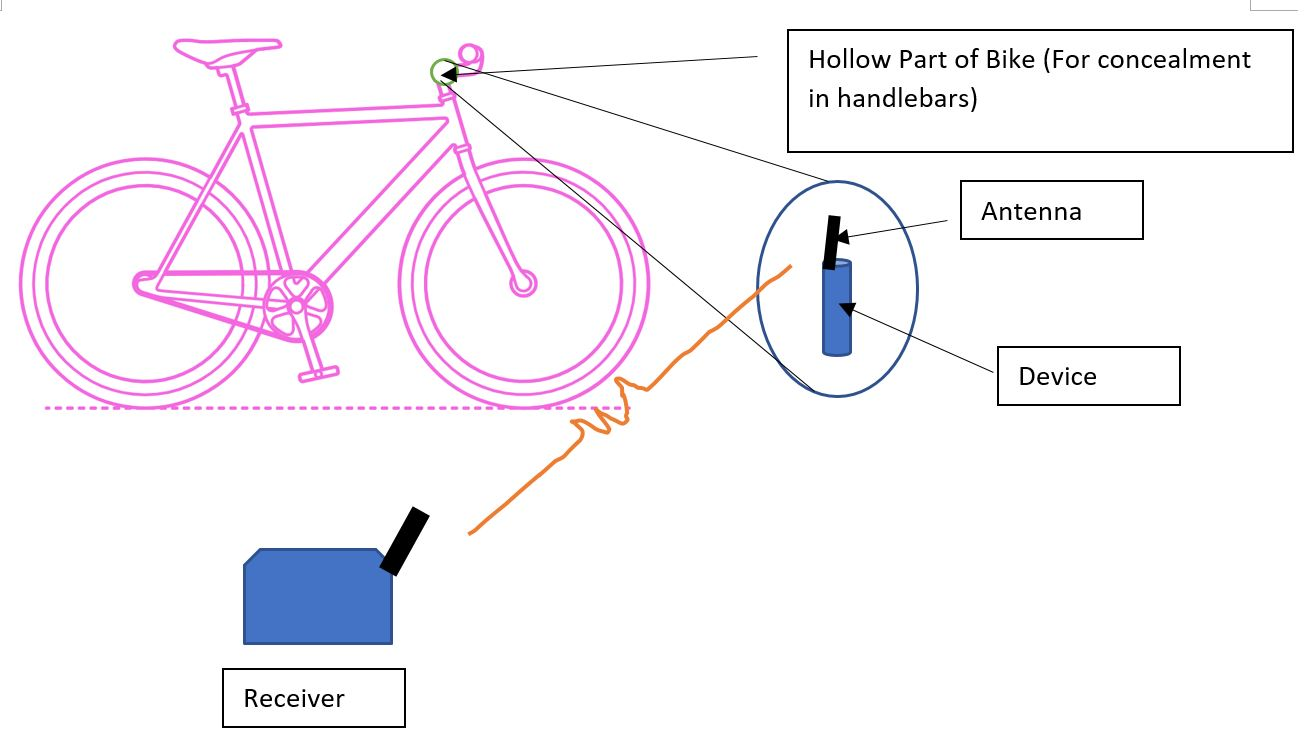
Documentation/Design Document/visual_aid.JPG
