eatkinso/bike-anti-theft-device/Documentation/Proposal/block_diagram_full.png

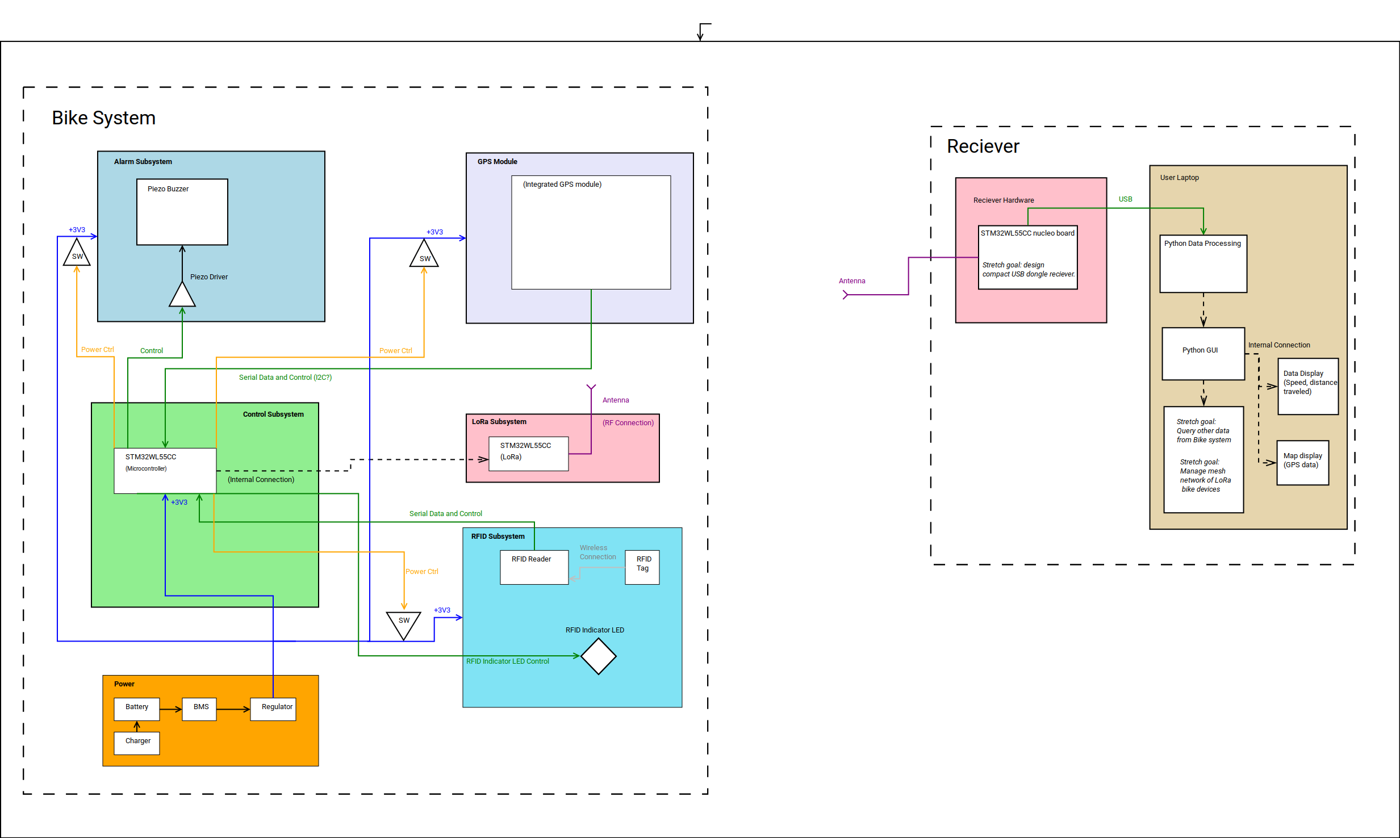
Documentation/Proposal/block_diagram_full.png
