eatkinso/bike-anti-theft-device/notebooks/Alex/data.png

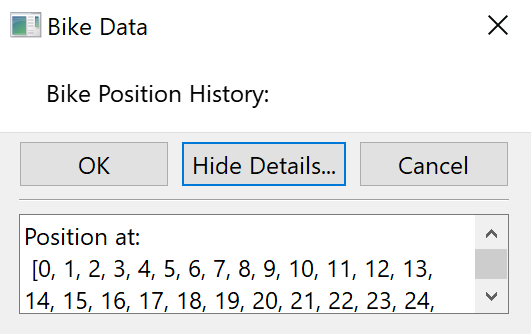
notebooks/Alex/data.png
