eatkinso/bike-anti-theft-device/notebooks/Alex/main.png

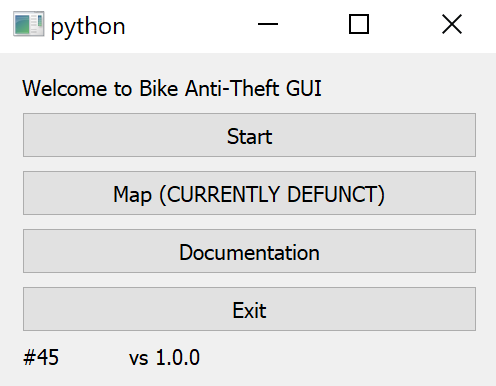
notebooks/Alex/main.png
