eatkinso/bike-anti-theft-device/notebooks/Elizabeth/f401pinout.png

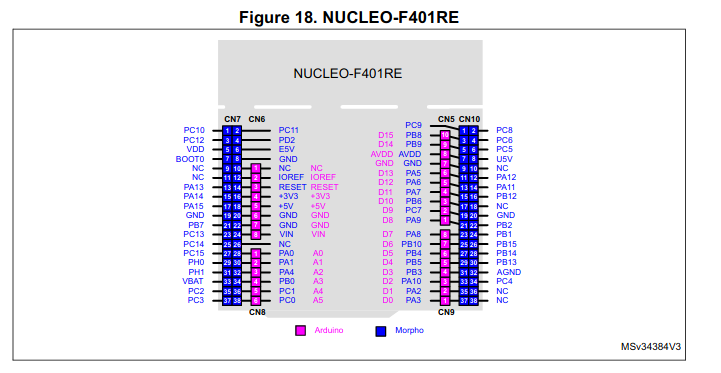
notebooks/Elizabeth/f401pinout.png
