eatkinso/bike-anti-theft-device/notebooks/Elizabeth/txnucleo.jpg

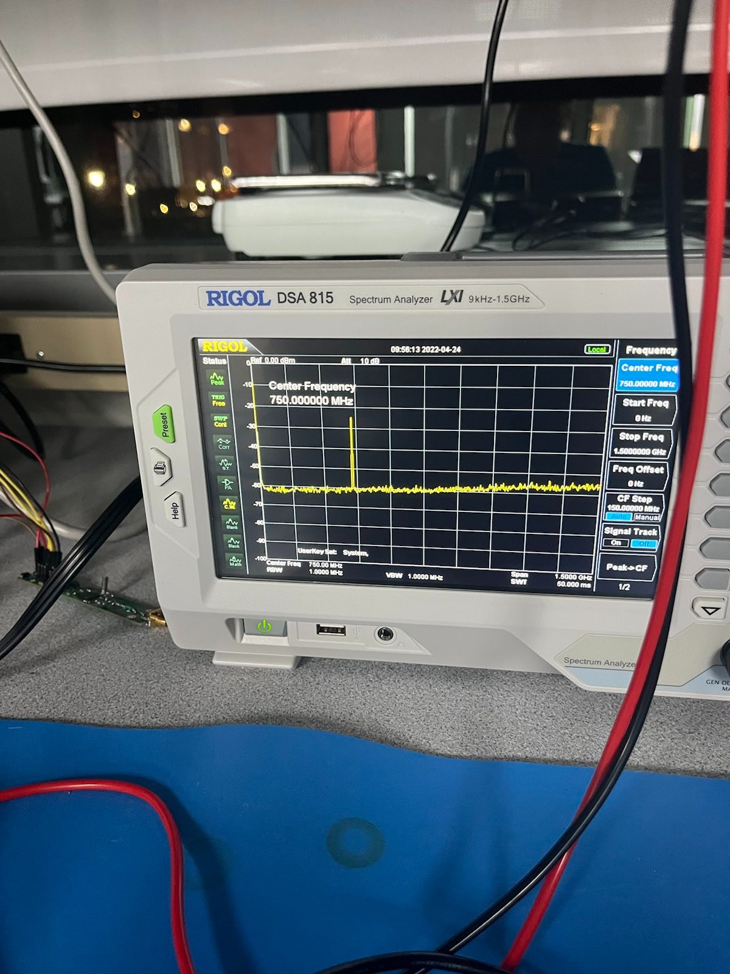
notebooks/Elizabeth/txnucleo.jpg
