eatkinso/bike-anti-theft-device/Hardware/bike_alarm/bike_alarm_materials.xlsx

Index | Quantity | Part Number | Manufacturer Part Number | Description | Customer Reference | Available | Backorder | Unit Price | Extended Price USD
1 | 5 | A106055CT-ND | CRG0805F10R | RES SMD 10 OHM 1% 1/8W 0805 | R1 | 5 | 0 | 0.1 | 0.50
2 | 5 | A119894CT-ND | RN73C2A1K0BTD | RES SMD 1K OHM 0.1% 1/10W 0805 | R2 | 5 | 0 | 0.78 | 3.90
3 | 5 | 609-3504-ND | 68000-403HLF | CONN HEADER VERT 3POS 2.54MM | J1 | 5 | 0 | 0.18 | 0.90
4 | 5 | 490-7709-ND | 7BB-12-9 | BUZZER ELEMENT STD 9KHZ 12MM | Y1 | 5 | 0 | 0.3 | 1.50
5 | 5 | 3757-PJA3404_R1_00001CT-ND | PJA3404_R1_00001 | SOT-23, MOSFET | Q1 | 5 | 0 | 0.38 | 1.90
