eatkinso/bike-anti-theft-device/Hardware/STrefboards/en.STM32WL_Reference_Board_MB1720-XO_IOs_Shield/Manufacturing/3.1. BOM/BOM/STM32WL_UFQFPN48_Reference_Design_+14dBm_433MHz.xlsx

Designator | Description | Package | Manufacturer | Manufacturer_Part_Number | Quantity | Internal_Part_Number
C1, C6, C10, C35 | Capacitor, MLCC, 4.7uF, 16V, X5R, 10%, 0603, T=0.8mm | C0603 | YAGEO | CC0603KRX5R7BB475 | 4
C2, C3, C4, C5, C7, C11, C12 | Capacitor, MLCC, 100nF, 16V, X7R, 10%, 0402, T=0,5mm | C0402 | YAGEO | CC0402KRX7R7BB104 | 7
C8, C9 | Capacitor, MLCC, 5.1 pF, 50V, NPO, +-0.1pF, 0402, T=0.5mm |  | YAGEO | CC0402CRNPO9BN5R1 | 2
C13, C23 | Capacitor, MLCC, 1nF, 16V, X7R, 10%, 0402, T=0.5mm |  | YAGEO | CC0402KRX7R7BB102 | 2
C14 | Capacitor, MLCC, 4.7 uF, 16V, X5R, 10%, 0603, T=0.8mm | C0603 | YAGEO | CC0603KRX5R7BB474 | 1
C15, C18, C20, C26, C27, C28, C29, C31, SB4, SB5, SB7, SB9 | [NoValue], RF Capacitor, Capacitor, MLCC, 6.8pF, 50V, NPO, +-0.1pF, 0402, T=0.5mm, Solder Bridge Open [0402] (Unpopulated) | [NoParam], C0402 |  |  | 12
C17 | RF Capacitor |  | MURATA | GJM1555C1H5R1CB01 | 1
C19, C25 | RF Capacitor |  | [NoValue], MURATA | GRM1555C1E680JA01 | 2
C21 | RF Capacitor |  | MURATA | GJM1555C1H220GB01 | 1
C22 | RF Capacitor |  | MURATA | GJM1555C1H100GB01 | 1
C24, C30 | RF Capacitor |  | MURATA | GJM1555C1H4R7WB01 | 2
C32, C33, C34 | Capacitor, MLCC, 33pF, 50V, NPO, 2%, 0402, T=0,5mm |  | MURATA | GJM1555C1H330GB01D | 3
C36, C37 | 10pF ±1% 50V Ceramic Capacitor C0G, NP0 0402 (1005 Metric) |  | MURATA | GJM1555C1H100FB01D | 2
CN1, CN2 | Connector right-angle, pitch 2.54mm, 20 contacts |  | SAMTEC | TSW-120-07-L-S | 2
J1, J2 | Header 1x2 Through hole 2.54mm |  | MOLEX | 22-03-2021 | 2
J4 | SMA Jack, Edge Mount, 50 Ohms |  | SAMTEC | SMA-J-P-H-ST-EM1 | 1
L1 | SMD Chip ferrite bead, 600R@100MHz +/-25%, 350mA, 500mohm DC, 0603, T=0.8mm |  | TAI-TECH | FCM1608KF-601T03 | 1
L2 | MLZ2012 Multilayer Shielded Inductor 15µH, ±5% |  | TDK | MLZ2012M150W | 1
L3 | RF Inductor |  |  | LQW15AN56NG00 | 1
L4 |  |  | MURATA | LQW15AN5N6C10 | 1
L5 | RF Inductor |  | MURATA | LQW15AN16NG00 | 1
L6, L7, SB1, SB2, SB3, SB6, SB8, SB11, SB13, SB14 | Zero ohm resistor, Solder Bridge 0R [0402] (Populated with 0 Ohm) |  | Vishay / Dale, [NoValue] | RCS04020000Z0ED | 10
L8 | RF Inductor |  | MURATA | LQW15AN39NG00 | 1
R1 | Resistor,10K,0603,1%,1/10W |  | YAGEO | RC0603FR-0710KL | 1
R2, R3 | Resistor,100R,0402,1%,1/16W |  | YAGEO | RC0402FR-07100RL | 2
RF BoM, SB10 | [NoValue], Solder Bridge |  |  |  | 2
S1 | RF Shield Frame + Cover without apertures |  | Masach Tech | MS409-10 | 1
U2 | ESD protection 6V1 |  | STMICROELECTRONICS | ESDALC6V1-1U2 | 1
U3 | DC switch - Ultra-Low SPDT analog switch |  | INFINEON | BGS12SN6 | 1
U4 | HQDC : Verified April, 25 2019 |  | STMicroelectronics | STM32WLxxxx | 1
X1 | Crystal 32.768kHz, 6pF, -+20PPM, R=80K, SMD |  | NDK | NX2012SA 32.768KHz EXS00A-MU00527 | 1
X2 | Crystal 32 MHz, 8pF, -+10 PPM, R=60Ω, SMD |  | NDK | NX2016SA 32MHz EXS00A-CS06465 | 1
