eatkinso/bike-anti-theft-device/Hardware/STrefboards/MB1552B/STM32WL_UFQFPN48_REF_BOARD_High_Power_High_Band_868-915MHz.PDF

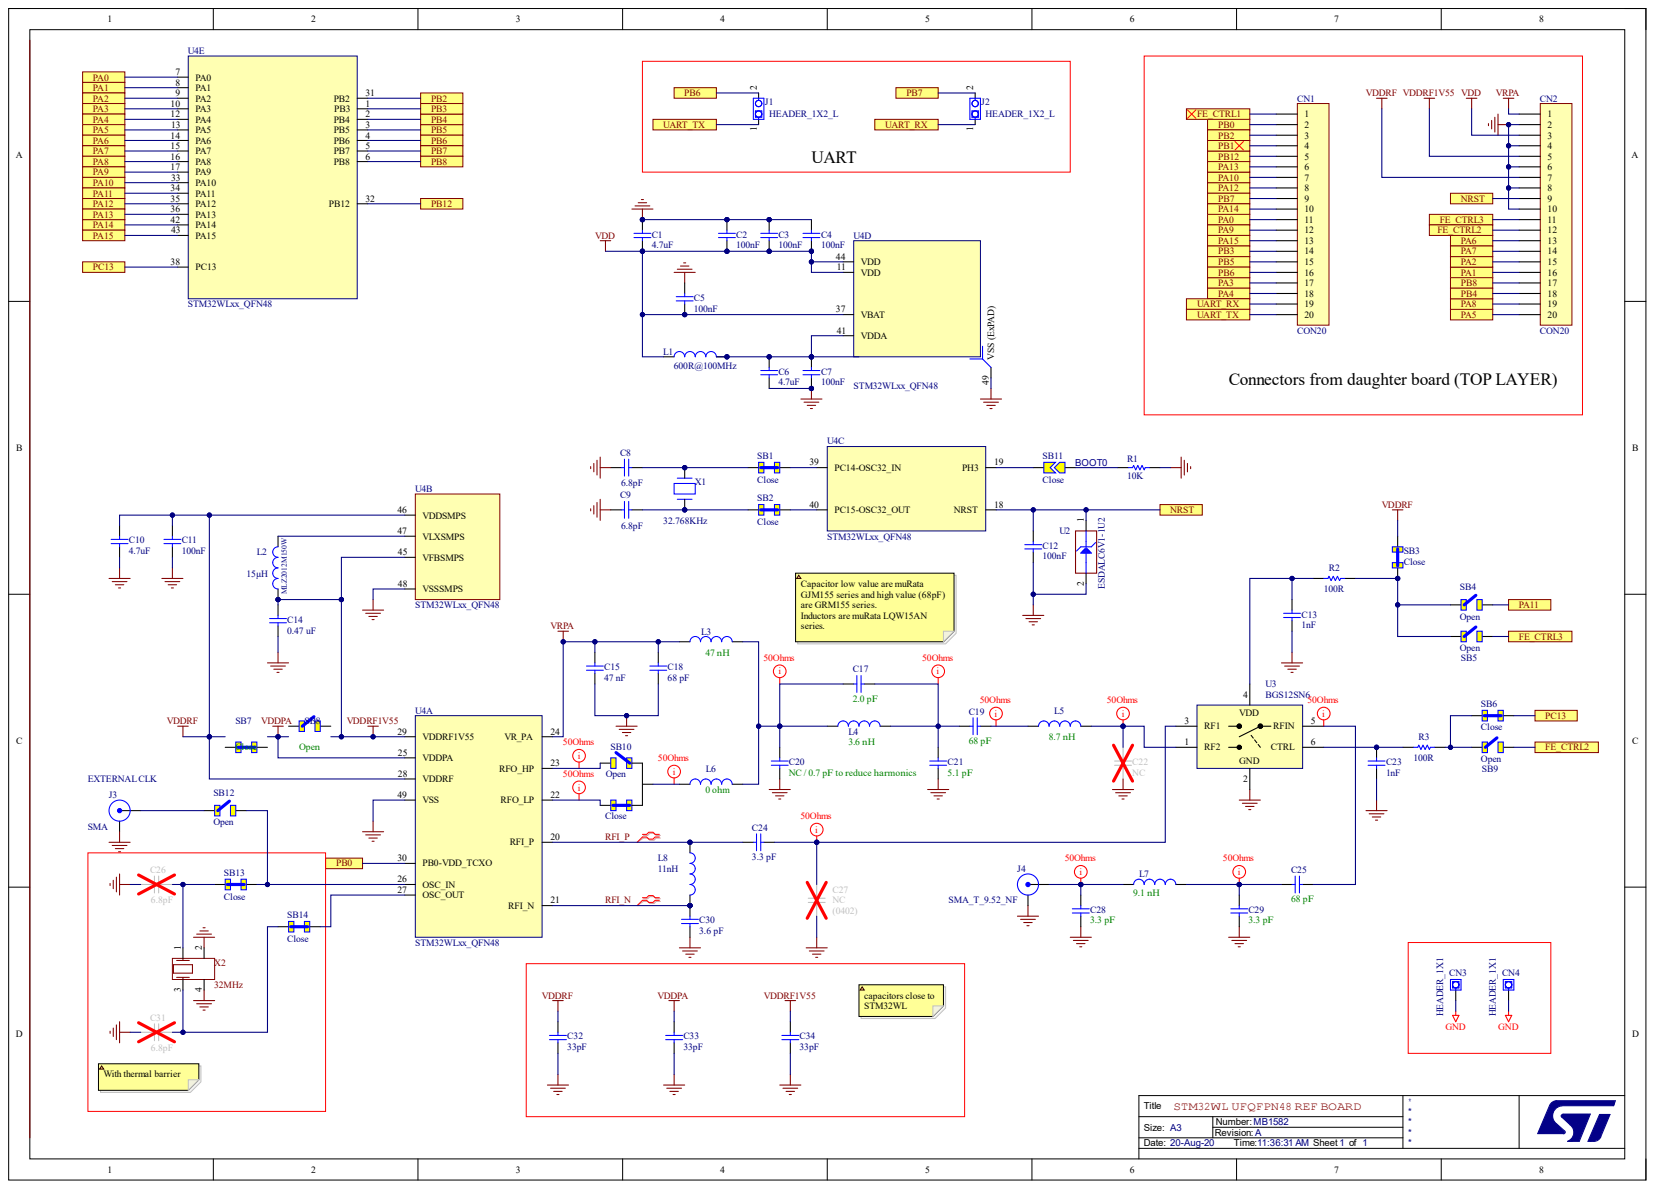
[picture p94: page 1]

Connectors from daughter board (TOP LAYER)

VLXSMPS 47

VSSSMPS 48

Capacitor low value are muRata
GJM155 series and high value (68pF)
are GRM155 series.
Inductors are muRata LQW15AN
series.

NC / 0.7 pF to reduce harmonics
