eatkinso/bike-anti-theft-device/Hardware/STrefboards/MB1552B/STM32WL_UFQFPN48_REF_BOARD_High_Power_Low_Band_490MHz.pdf

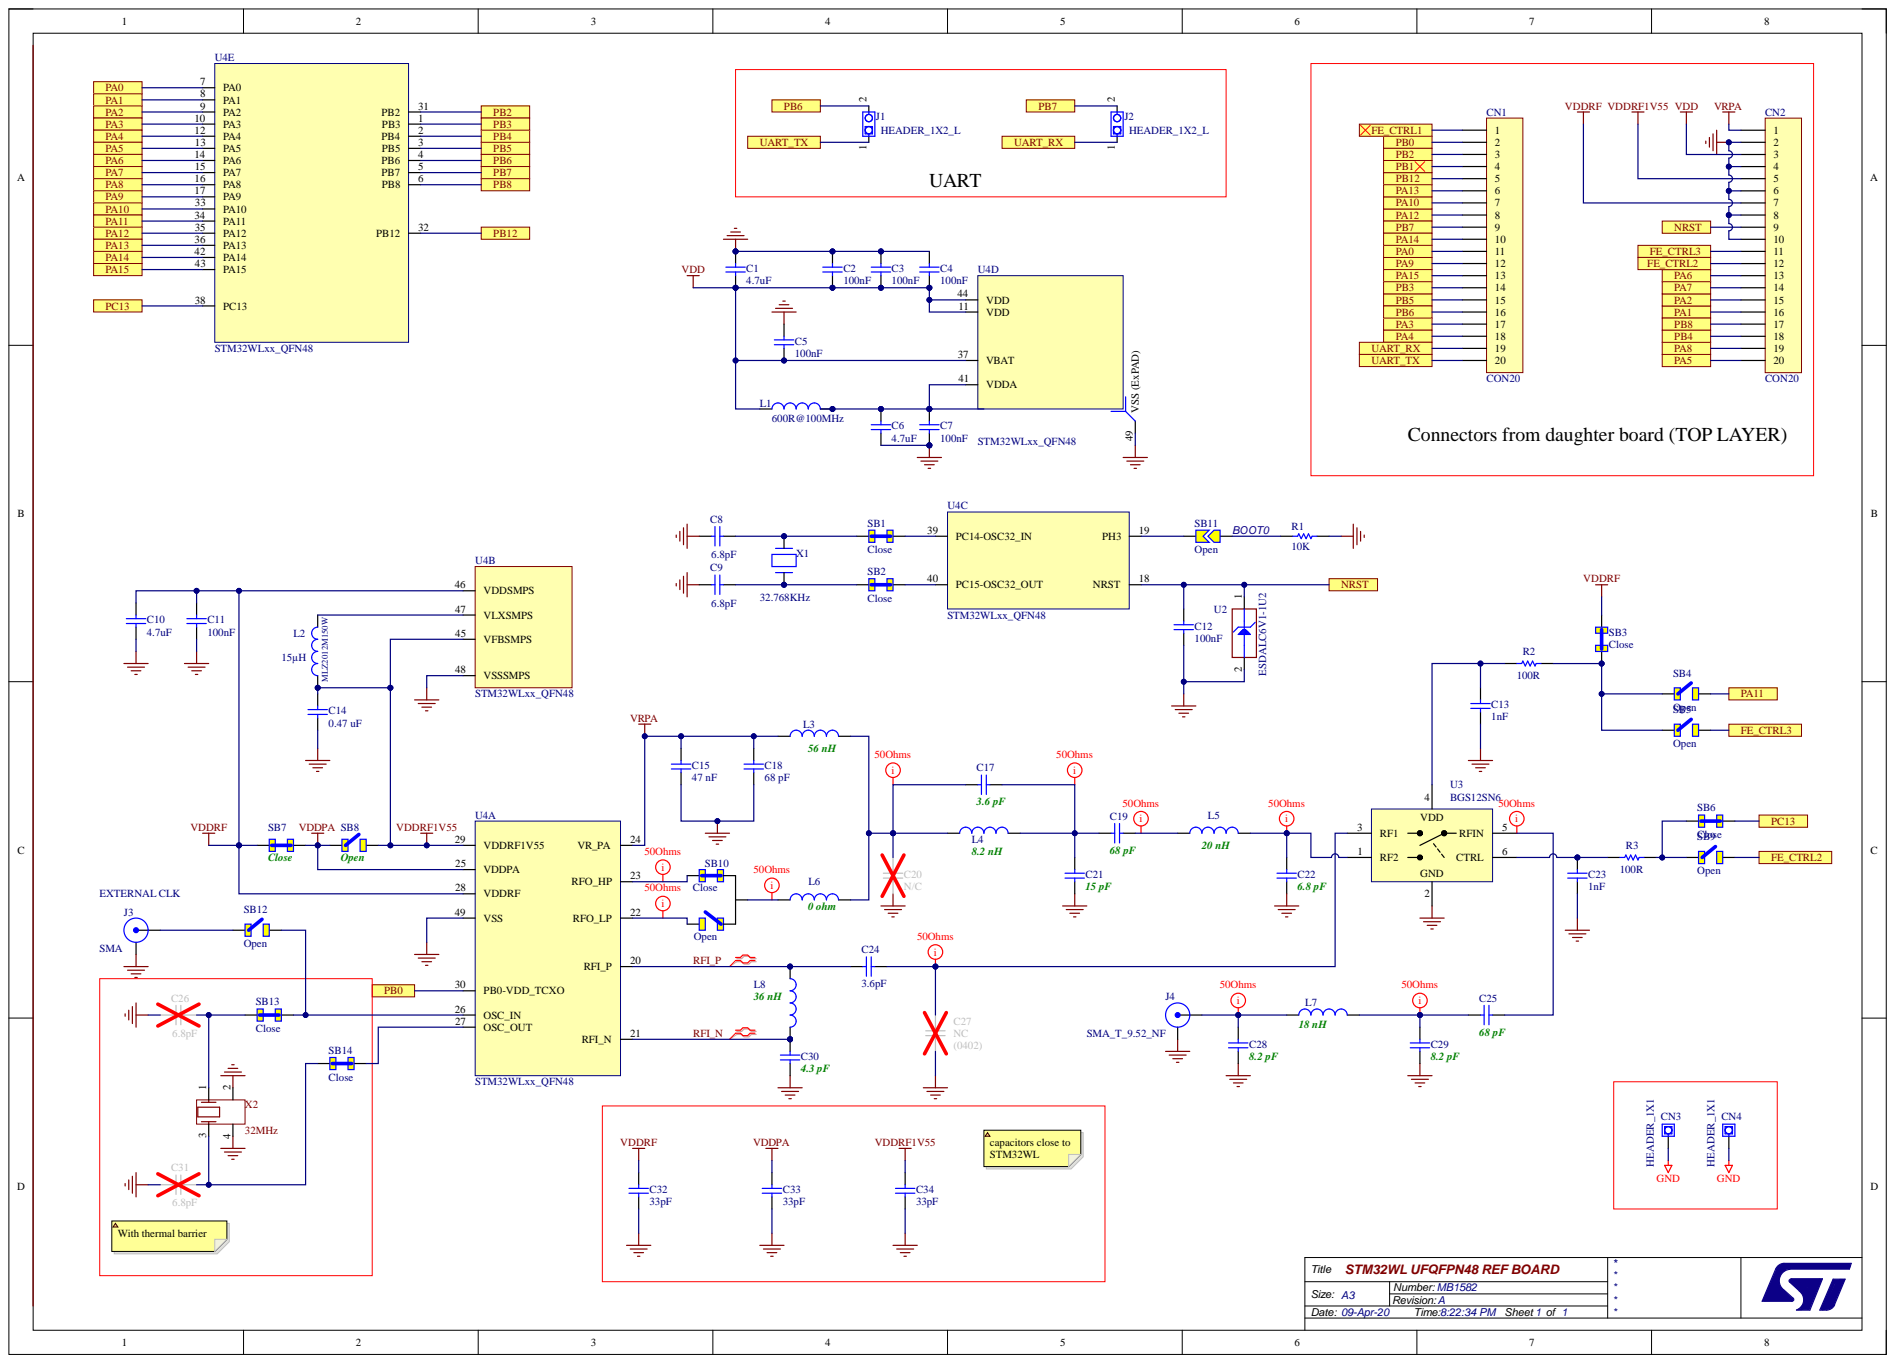
[picture p95: page 1]

PA4 | PB4
PA5 | PB5

VDDA 41

Connectors from daughter board (TOP LAYER)

Close | PC15-OSC32_OUT 40

VLXSMPS 47

VFBSMPS 45
