eatkinso/bike-anti-theft-device/Hardware/STrefboards/en.STM32WL_Reference_Board_MB1720-XO_IOs_Shield/Manufacturing/3.2. Schematic, Assy & 3D PDF/Schematic/STM32WL_UFQFPN48_Reference_Design_+14dBm_433MHz.PDF

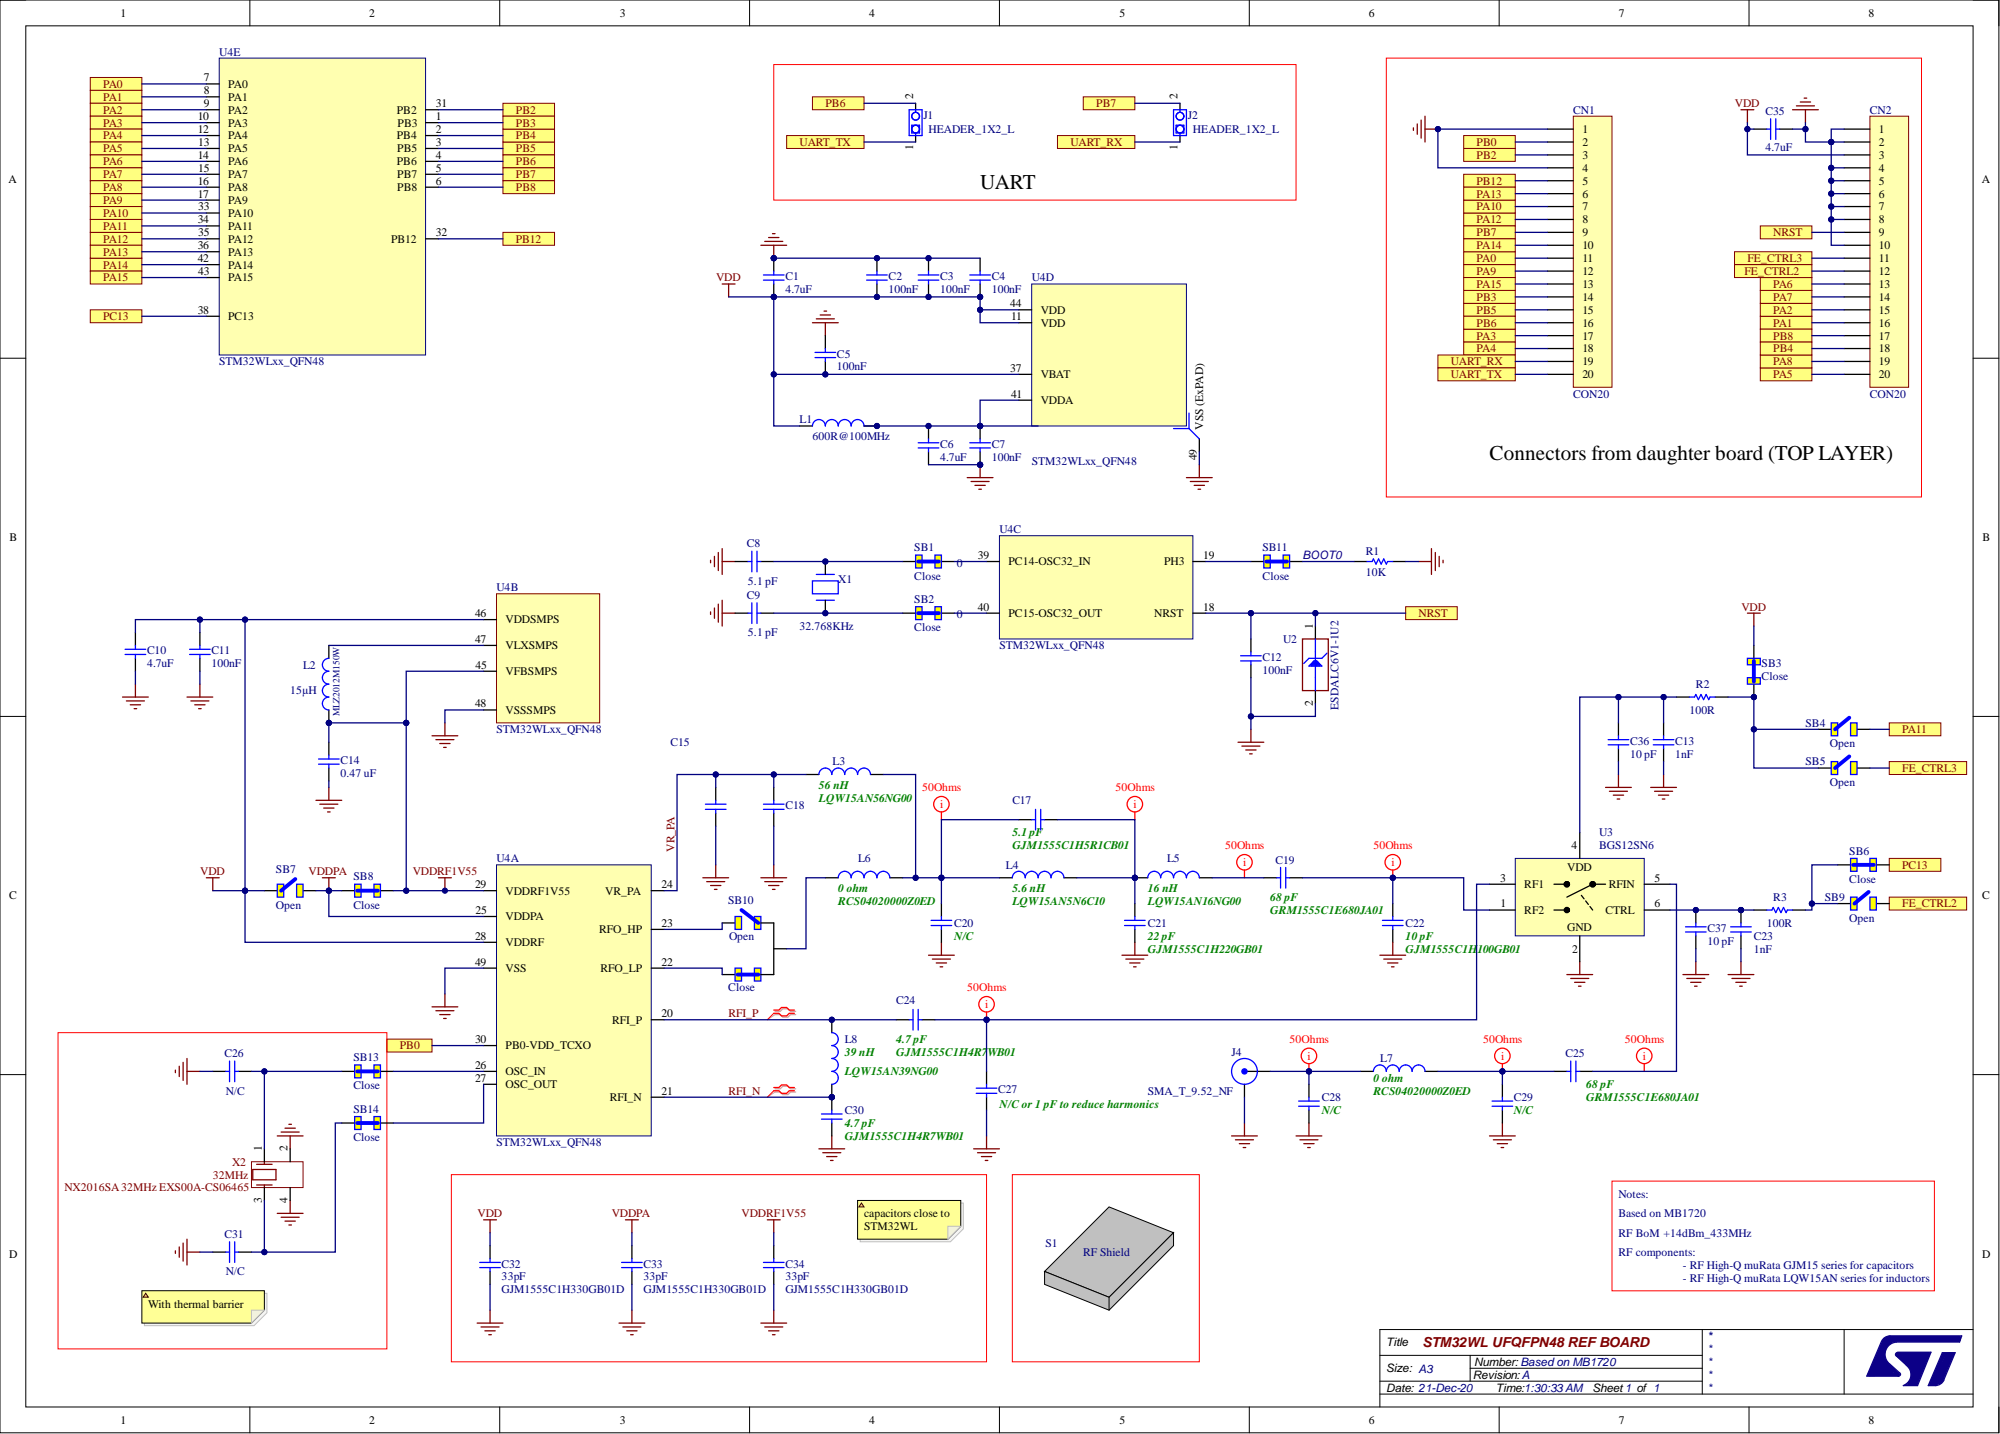
[picture p96: page 1]

PA5 | PB5
PA6 | PB6

VDDA 41

Connectors from daughter board (TOP LAYER)

VLXSMPS 47

VFBSMPS 45

VSSSMPS 48

N/C or 1 pF to reduce harmonics

- RF High-Q muRata GJM15 series for capacitors
- RF High-Q muRata LQW15AN series for inductors

Size: A3 | Number: Based on MB1720
