eatkinso/bike-anti-theft-device/Hardware/STrefboards/en.STM32WL_Reference_Board_MB1720-XO_IOs_Shield/Manufacturing/2.5. Gerber PDF file/STM32WL_UFQFPN48_Reference_DesignBoard_PCB_Revision_Gerber.PDF

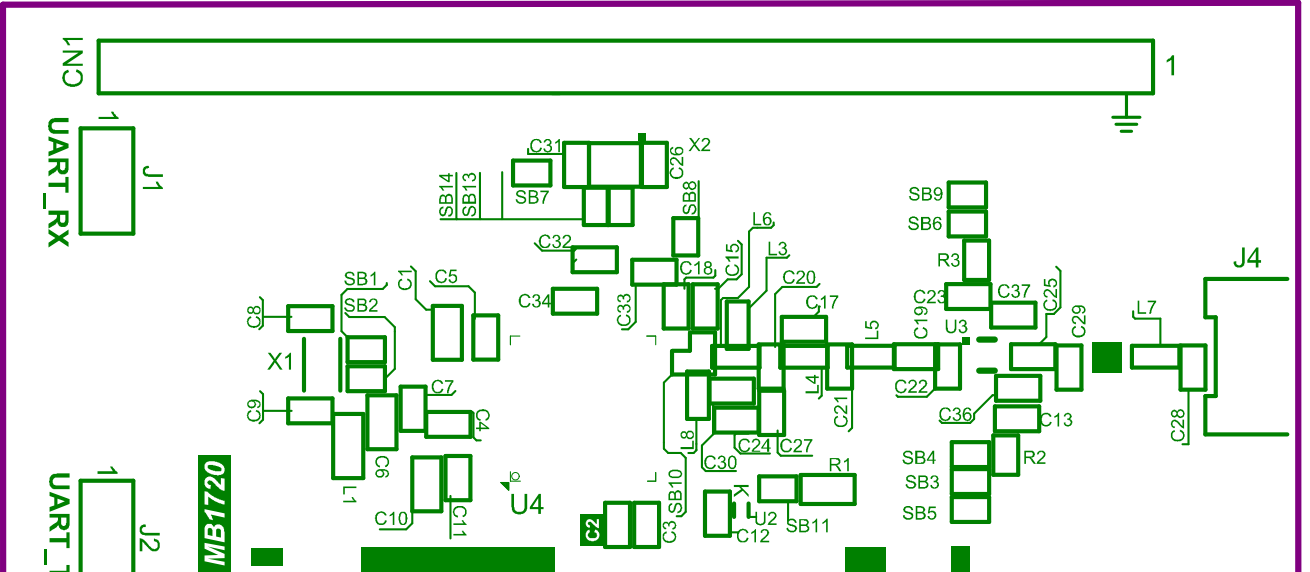
[picture p97: page 1]

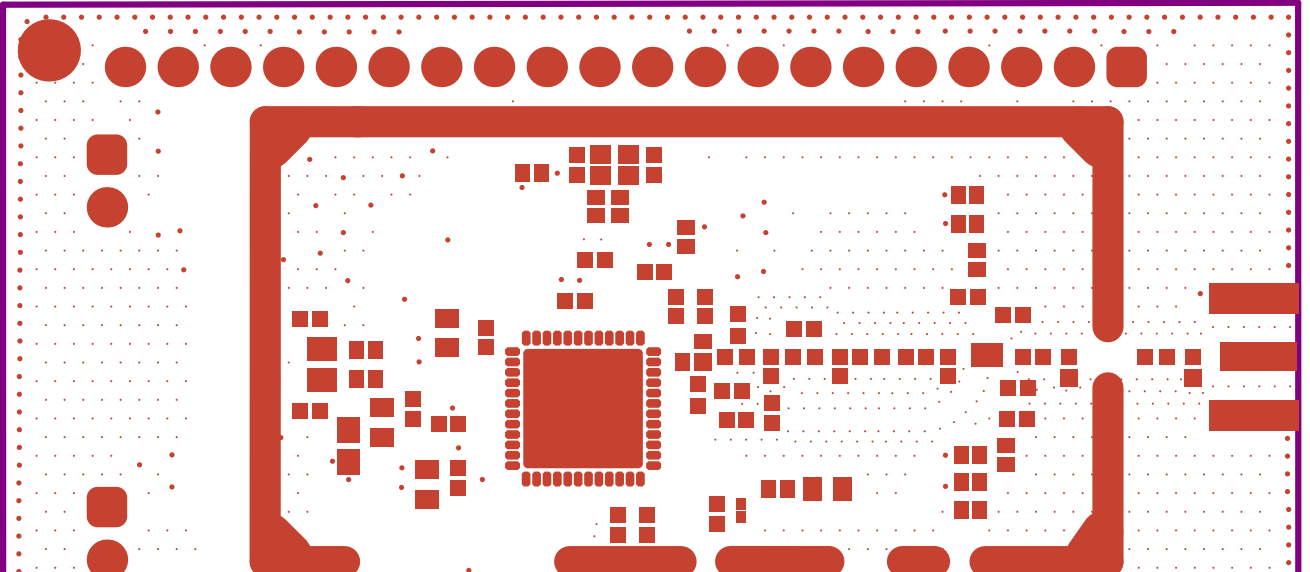
[picture p98: page 2]

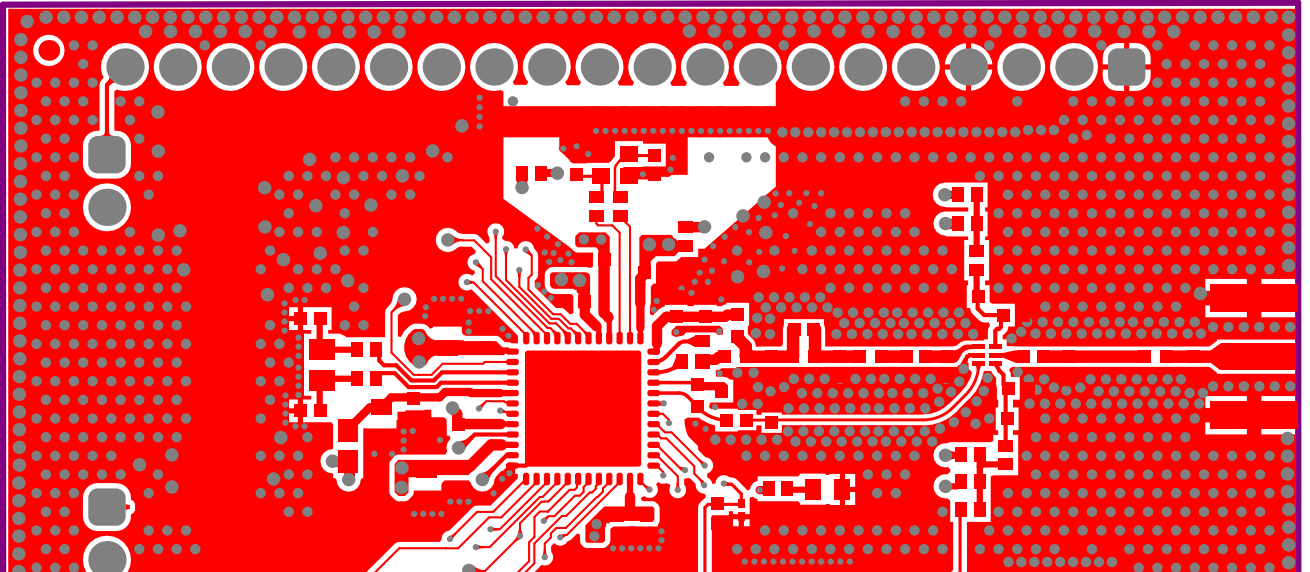
[picture p99: page 3]

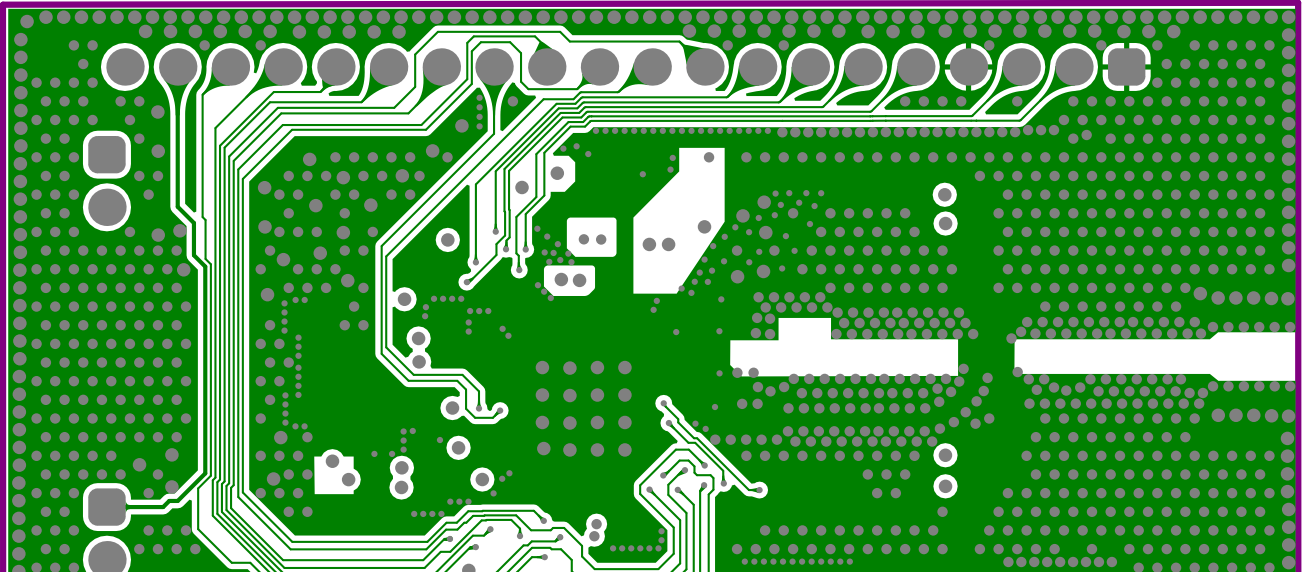
[picture p100: page 4]

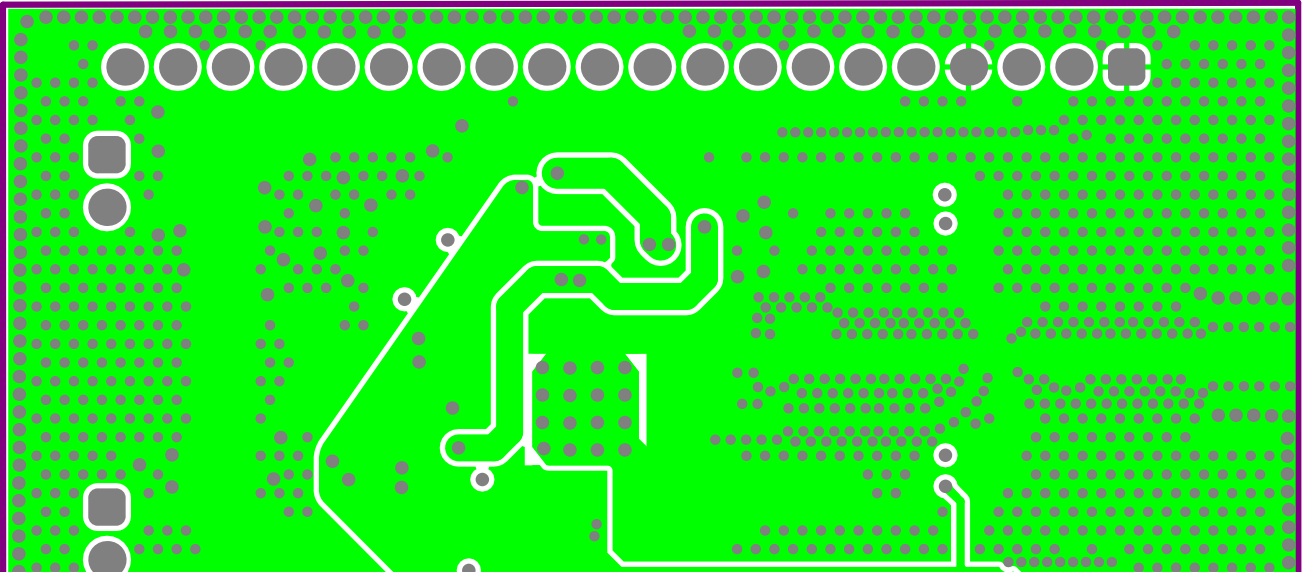
[picture p101: page 5]

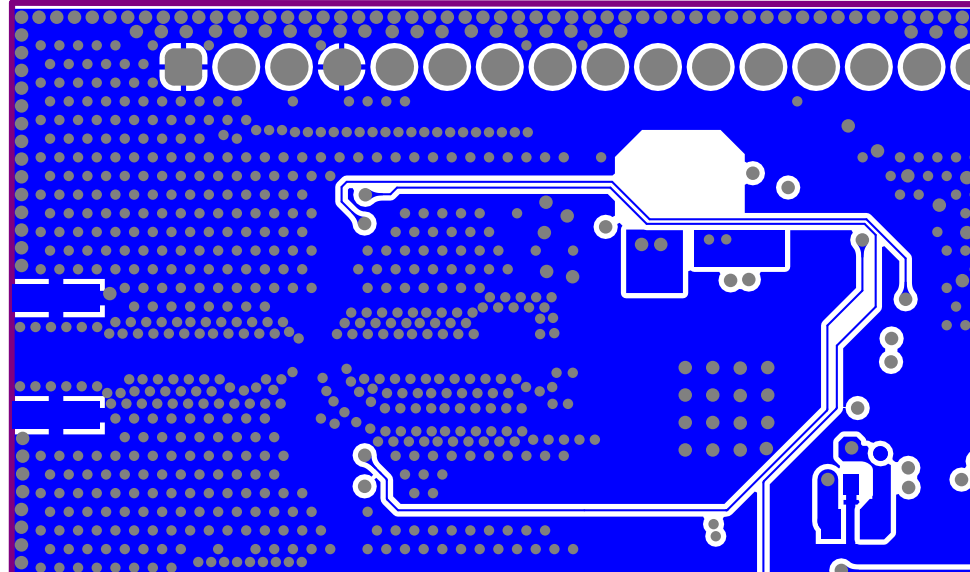
[picture p102: page 6]

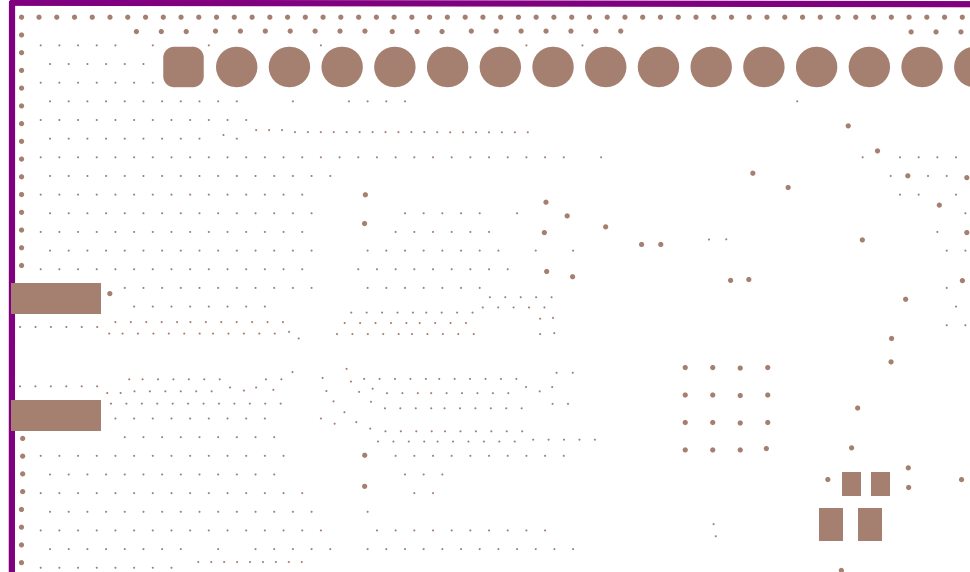
[picture p103: page 7]

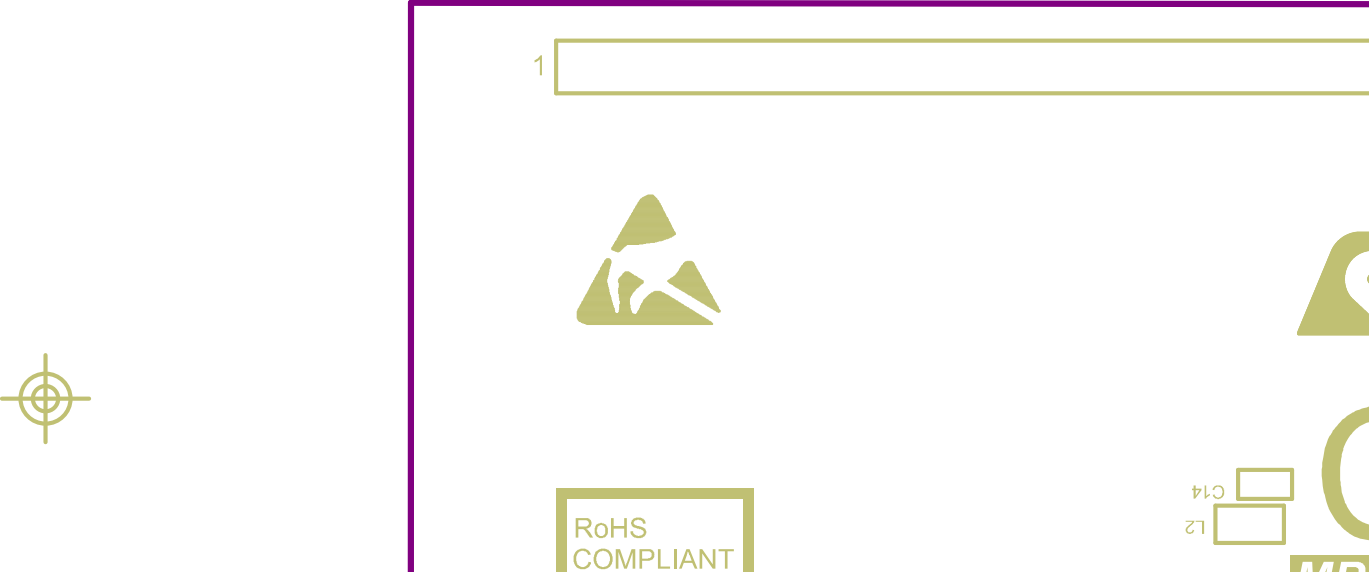
[picture p104: page 8]

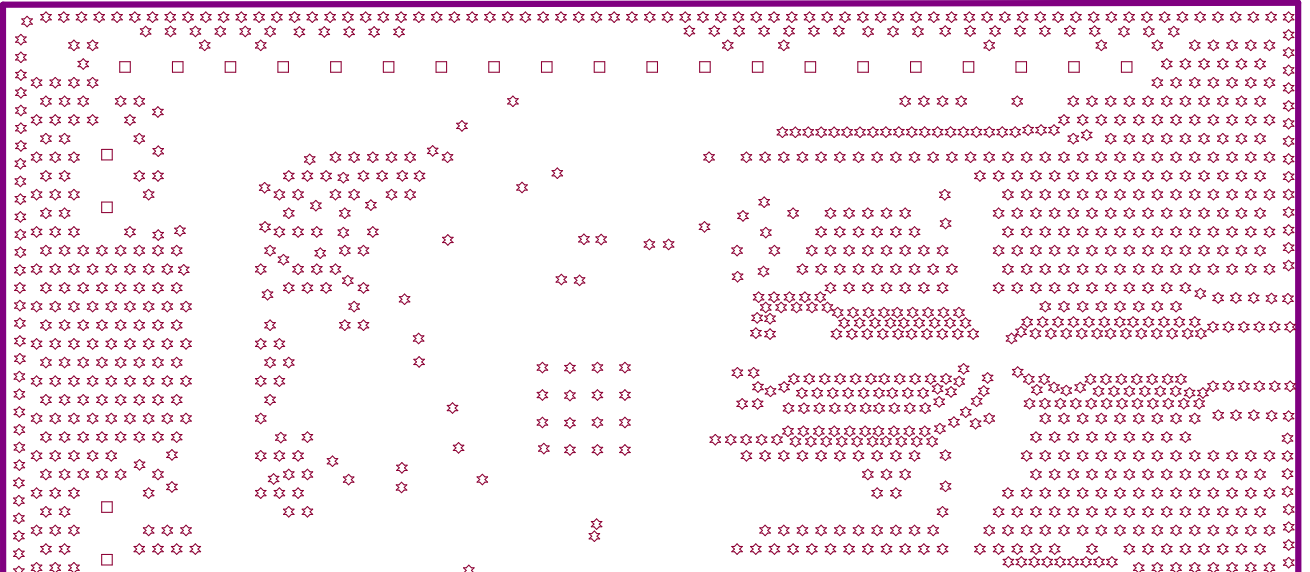
[picture p105: page 9]
