eatkinso/bike-anti-theft-device/Hardware/STrefboards/en.STM32WL_Reference_Board_MB1720-XO_IOs_Shield/Manufacturing/3.2. Schematic, Assy & 3D PDF/PCB Print/Assembly Drawings.PDF

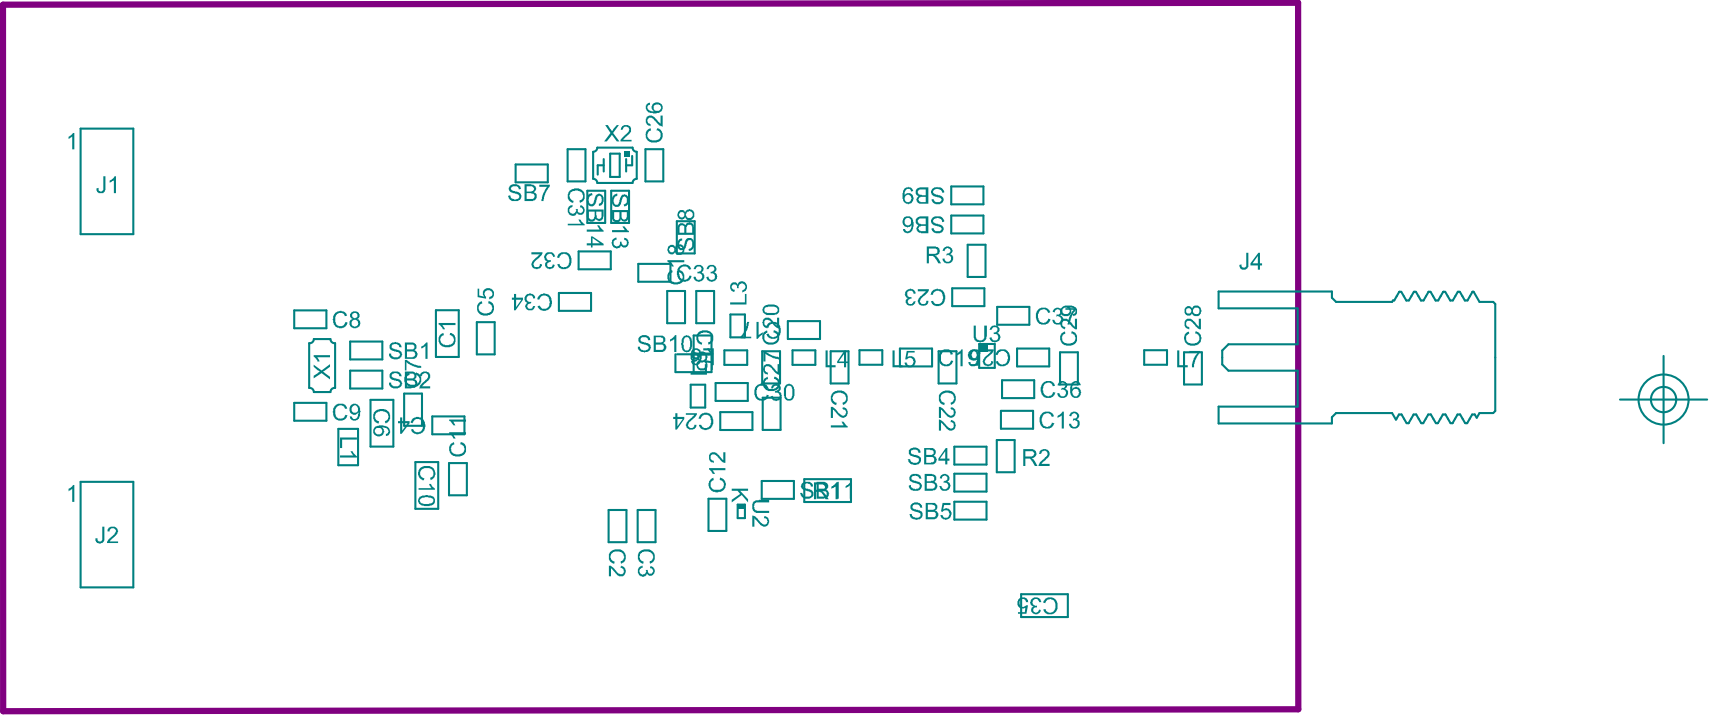
[picture p106: page 1]

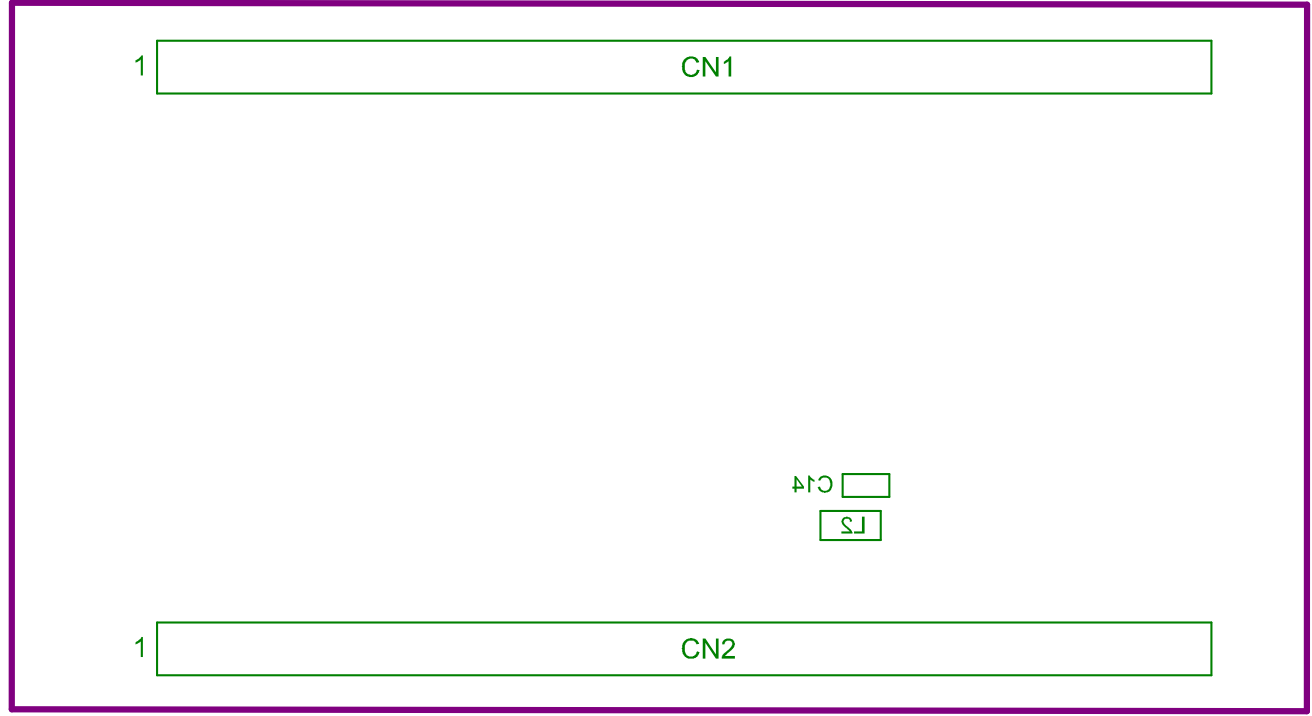
[picture p107: page 2]
