eatkinso/bike-anti-theft-device/Hardware/STrefboards/en.STM32WL_Reference_Board_MB1720-XO_IOs_Shield/Manufacturing/3.2. Schematic, Assy & 3D PDF/PCB Print/Layout.PDF

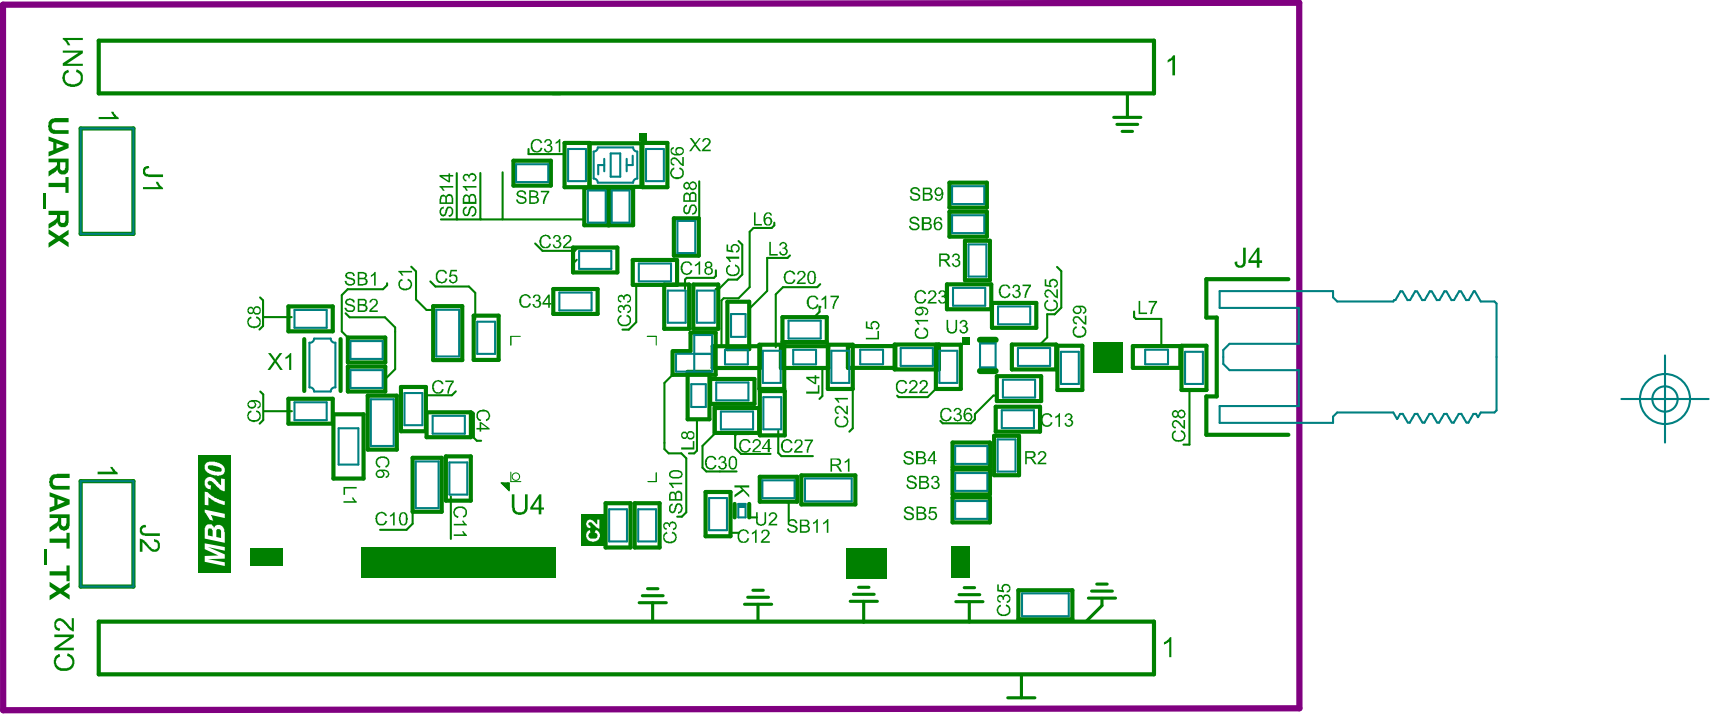
[picture p108: page 1]

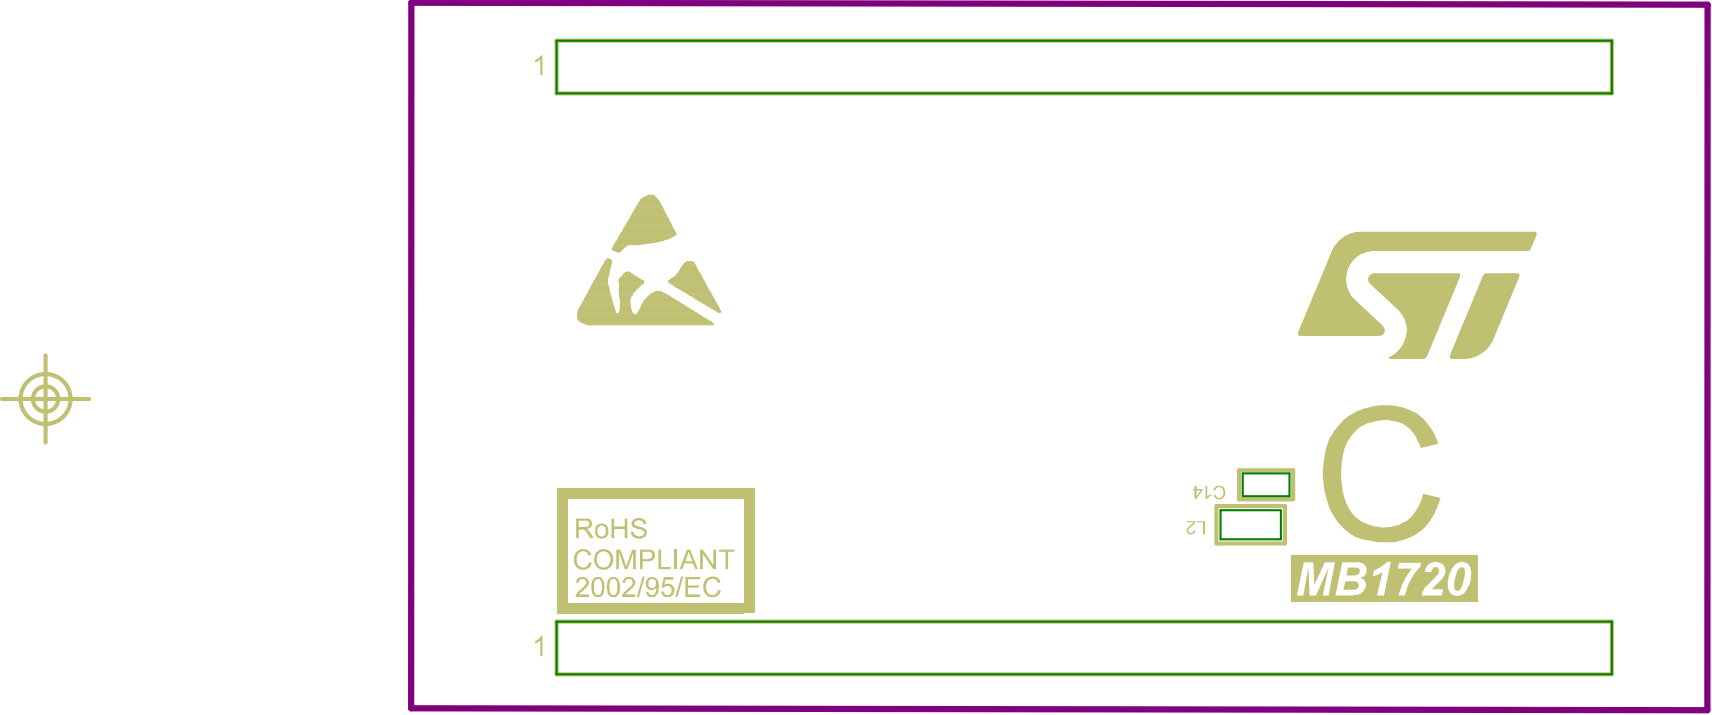
[picture p109: page 2]
