eatkinso/bike-anti-theft-device/Hardware/STrefboards/en.STM32WL_Reference_Board_MB1720-XO_IOs_Shield/Manufacturing/4.1. Layout & Dimensions PDF for Documentation/PCB Print/BOTTOM Dimensions.PDF

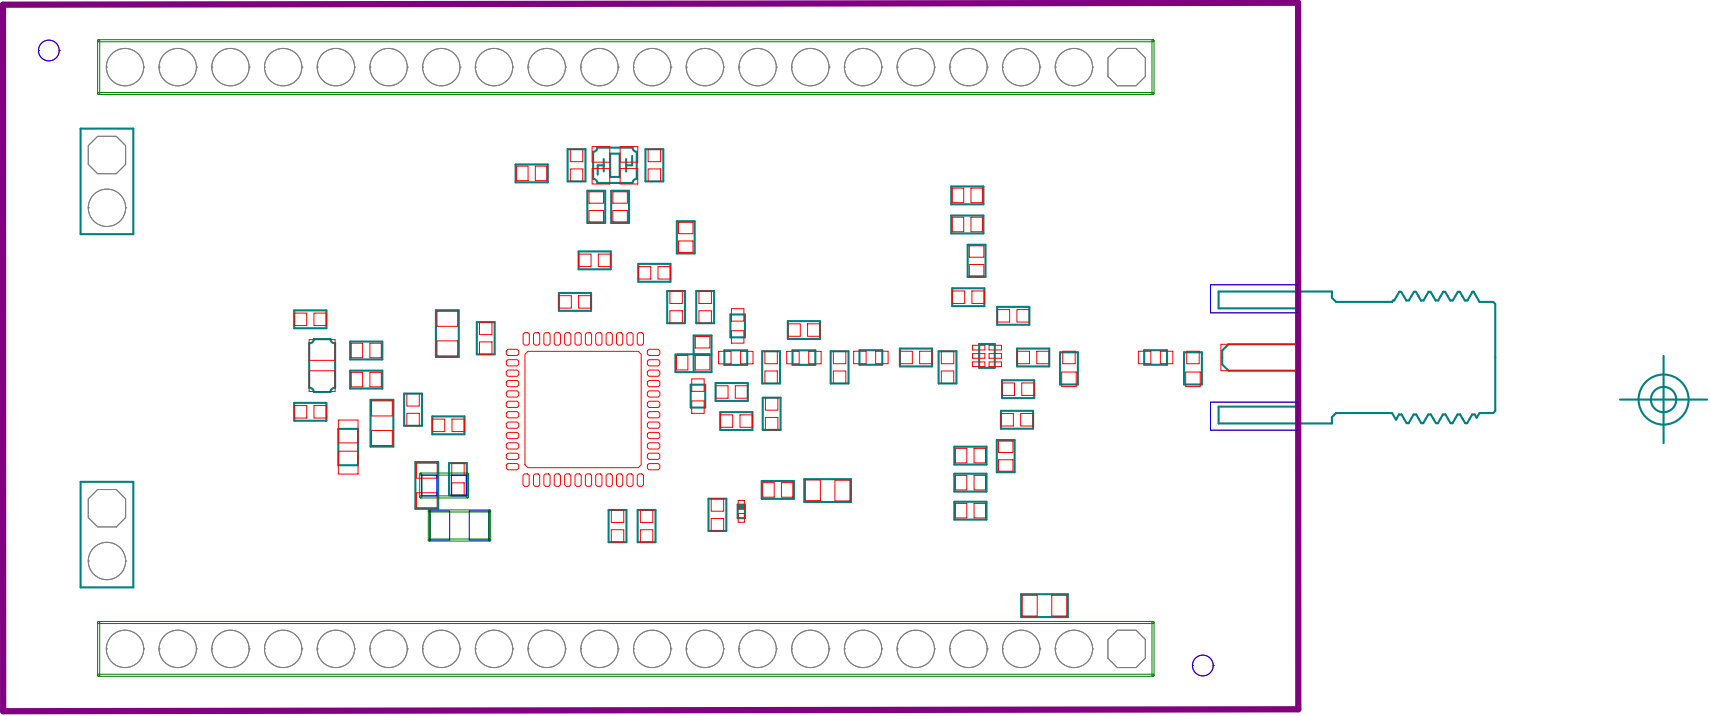
[picture p111: page 1]
