eatkinso/bike-anti-theft-device/(list of files, drawings)

Other design files:
Hardware/STrefboards/en.STM32WL_Reference_Board_MB1720-XO_IOs_Shield/Project Altium Designer 2020/MB1720.PcbLib
Hardware/STrefboards/en.STM32WL_Reference_Board_MB1720-XO_IOs_Shield/Project Altium Designer 2020/STM32WL_UFQFPN48_Ref_Board.SchDoc
Hardware/STrefboards/en.STM32WL_Reference_Board_MB1720-XO_IOs_Shield/Project Altium Designer 2020/STM32WL_UFQFPN48_Reference_Design.PrjPcb
Hardware/STrefboards/en.STM32WL_Reference_Board_MB1720-XO_IOs_Shield/Project Altium Designer 2020/STM32WL_UFQFPN48_Reference_Design.SCHLIB
