eatkinso/bike-anti-theft-device/Hardware/main_board/main_board_bodged.kicad_pcb

## KiCad design Hardware/main_board/main_board_bodged.kicad_pcb (2022-04-25)

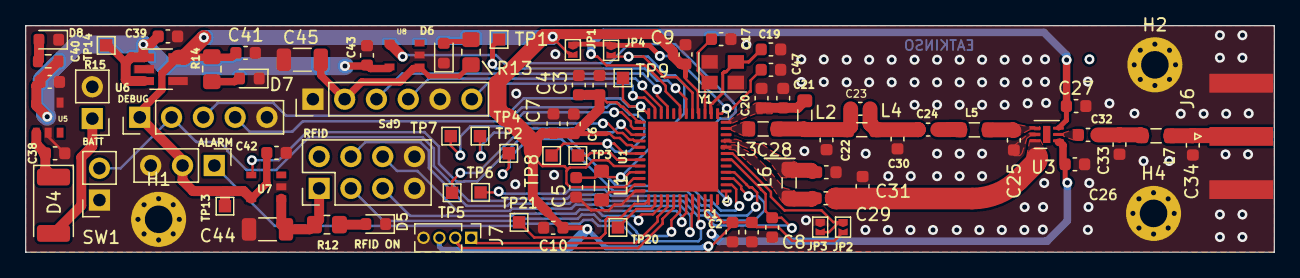
[picture p112: board main_board_bodged.kicad_pcb from above]

Board: 2 copper layers, 99.8 x 18.1 mm, 87 parts (0 on the bottom side), 55 nets.

Parts:
C1, C3, C9, C10: 4.7u; C_0603_1608Metric
C2, C4: 100n; C_0603_1608Metric
C5: 470n; C_0603_1608Metric
C6, C38, C39, C40, C41, C42, C43, C47: 1u; C_0603_1608Metric
C7: 10n; C_0603_1608Metric
C8: 0.1u; C_0603_1608Metric
C17, C19: 22p; C_0603_1608Metric
C20: 47n; C_0603_1608Metric
C21, C24: 68p; C_0603_1608Metric
C22: 0.7p; C_0603_1608Metric
C23: 2p; C_0603_1608Metric
C25: DNP; C_0603_1608Metric
C26, C27: 1000p; C_0603_1608Metric
C28: 4.7p; C_0603_1608Metric
C29: 3p; C_0603_1608Metric
C30: 5.1p; C_0603_1608Metric
C31: 1p; C_0603_1608Metric
C32: 56p; C_0603_1608Metric
C33, C34: 3.3p; C_0603_1608Metric
C44, C45: 10u; C_1206_3216Metric
D4: D; D_2010_5025Metric
D5, D6, D7, D8: LED; LED_0603_1608Metric
H1, H2, H4: MountingHole_Pad; MountingHole_2.2mm_M2_Pad_Via
J1: ALARM; PinHeader_1x03_P2.54mm_Vertical
J2: RFID_CONN; PinHeader_2x04_P2.54mm_Vertical
J3: GPS_CONN; PinHeader_1x06_P2.54mm_Vertical
J5: DEBUG; PinHeader_1x05_P2.54mm_Vertical
J6: ANTENNA2; SMA_Amphenol_132289_EdgeMount
J7: Conn_01x04_Male; PinHeader_1x04_P1.27mm_Vertical
J8: BATT; PinHeader_1x02_P2.54mm_Vertical
JP1: SolderJumper_2_Bridged; tinyjumper
JP2, JP3, JP4: SolderJumper_2_Open; tinyjumper
L1: 15u; L_0805_2012Metric_Pad1.05x1.20mm_HandSolder
L2: 47n; L_0805_2012Metric_Pad1.05x1.20mm_HandSolder
L3: 4.45n; L_0805_2012Metric_Pad1.05x1.20mm_HandSolder
L4: 3.6n; L_0805_2012Metric_Pad1.05x1.20mm_HandSolder
L5: 8.7n; L_0805_2012Metric_Pad1.05x1.20mm_HandSolder
L6: 11n; L_0805_2012Metric_Pad1.05x1.20mm_HandSolder
L7: 9.1n; L_0805_2012Metric_Pad1.05x1.20mm_HandSolder
R12, R13, R14: 200R; R_0805_2012Metric_Pad1.20x1.40mm_HandSolder
R15: 200R; R_0603_1608Metric
SW1: SW_Push; PinSocket_1x02_P2.54mm_Vertical
TP1, TP2, TP3, TP4, TP5, TP6, TP7, TP8, TP9, TP13, TP14, TP20, TP21: TestPoint; TestPoint_Pad_1.0x1.0mm
U1: STM32WL55_UFQFPN48; QFN-48-1EP_7x7mm_P0.5mm_EP5.6x5.6mm
U3: SKY13370-374LF; DFN-6-1EP_2x2mm_P0.5mm_EP0.6x1.37mm
U5: AP7370-50W5-7; SOT25
U6: S-1135A33-M5T1U; SOT-23-5_HandSoldering
U7, U8: AP22811BW5-7; SOT25
Y1: Crystal_GND24; Oscillator_SMD_Abracon_ASE-4Pin_3.2x2.5mm

Connections:
+3V3: C1.1, C2.1, C3.1, C4.1, C6.1, C7.1, C9.1, C10.1, C41.1, C42.1, J1.2, J5.1, J7.3, JP1.2 (B), JP2.2 (B), R14.1, TP13.1, U1.11 (VDD), U1.28 (VDDRF), U1.37 (VBAT), U1.41 (VDDA), U1.44 (VDD), U1.46 (VDDSMPS), U6.5 (VOUT), U7.5 (IN)
+3V3_RFID: C44.1, J2.1, R12.1, U7.1 (OUT)
+5V: C39.1, C40.1, C43.1, R15.2, TP14.1, U5.5 (VOUT), U6.1 (VIN), U6.3 (ON), U8.5 (IN)
+5V_GPS: C45.1, J3.2, R13.1, U8.1 (OUT)
DBUG_JTDO_SWO: TP21.1, U1.1 (PB3)
DEBUG_JTCK_SWCLK: J5.4, TP8.1, U1.42 (PA14)
DEBUG_JTDI: TP3.1, U1.43 (PA15)
DEBUG_JTMS_SWDIO: J5.3, TP9.1, U1.36 (PA13)
DEBUG_JTRST: TP20.1, U1.2 (PB4)
GND: C1.2, C2.2, C3.2, C4.2, C5.2, C6.2, C7.2, C8.2, C9.2, C10.2, C17.1, C19.1, C20.2, C21.2, C22.2, C25.2, C26.1, C27.2, C28.2, C30.2, C31.1, C33.2, C34.2, C38.2, C39.2, C40.2, C41.2, C42.2, C43.2, C44.2, C45.2, C47.2, D5.1 (K), D6.1 (K), D7.1 (K), D8.1 (K), H1.1, H2.1, H4.1, J1.3, J2.7, J2.8, J3.1, J3.5, J5.5, J6.2 (Ext), J7.4, J8.2, JP3.1 (A), SW1.1, U1.48 (VSSSMPS), U3.5 (GND), U5.2 (GND), U5.4 (NC), U6.2 (VSS), U6.4 (NC), U7.2 (GND), U8.2 (GND), Y1.2, Y1.4
GPS_~PWR: U1.13 (PA5), U8.4 (~EN)
LPUART1_NRX: C26.2, U1.10 (PA3), U3.1 (VC1)
LPUART1_NTX: J1.1, U1.9 (PA2)
NRST: C8.1, J5.2, SW1.2, U1.18 (NRST)
unnamed: C5.1, JP4.2 (B), L1.1, U1.29 (VDDRF1V55), U1.45 (VFBSMPS)
unnamed: C17.2, U1.27 (OSC_OUT), Y1.1
unnamed: C19.2, U1.26 (OSC_IN), Y1.3
unnamed: C20.1, C21.1, L2.1, U1.24 (VR_PA)
unnamed: C22.1, C23.1, L2.2, L3.2, L4.1
unnamed: C23.2, C24.1, C30.1, L4.2
unnamed: C24.2, L5.1
unnamed: C25.1, L5.2, U3.4 (RF2)
unnamed: C28.1, L6.1, U1.21 (RFI_N)
unnamed: C29.1, L6.2, U1.20 (RFI_P)
unnamed: C29.2, C31.2, U3.6 (RF1)
unnamed: C32.1, U3.2 (RFC)
unnamed: C32.2, C33.1, L7.1
unnamed: C34.1, J6.1 (In), L7.2
unnamed: C38.1, D4.1 (K), U5.1 (VIN)
unnamed: C47.1, JP1.1 (A), JP4.1 (A), U1.25 (VDDPA)
unnamed: D4.2 (A), J8.1
unnamed: D5.2 (A), R12.2
unnamed: D6.2 (A), R13.2
unnamed: D7.2 (A), R14.2
unnamed: D8.2 (A), R15.1
unnamed: JP2.1 (A), JP3.2 (B), U1.19 (PH3-BOOT0)
unnamed: L1.2, U1.47 (VLXSMPS)
unnamed: L3.1, U1.23 (RFO_HP)
unnamed: TP1.1, U1.30 (PB0-VDD_TXCO)
unnamed: TP2.1, U1.16 (PA8)
unnamed: TP4.1, U1.40 (PC15-OSC32_OUT)
unnamed: TP5.1, U1.39 (PC14-OSC32_IN)
unnamed: TP6.1, U1.15 (PA7)
unnamed: TP7.1, U1.38 (PC13)
PA0: J2.6, U1.7 (PA0)
PA1: J2.4, U1.8 (PA1)
PA11: J3.4, U1.34 (PA11)
PA12: J3.6, U1.35 (PA12)
PB5: J2.5, U1.3 (PB5)
PB7: J7.2, U1.5 (PB7)
PB8: J2.3, U1.6 (PB8)
RFID_~PWR: U1.14 (PA6), U7.4 (~EN)
RFSW_VC2: C27.1, U1.31 (PB2), U3.3 (VC2)
USART1_RX: J3.3, U1.33 (PA10)
USART1_TX: J7.1, U1.4 (PB6)
