eatkinso/bike-anti-theft-device/Hardware/usb_interface/test.kicad_pcb

## KiCad design Hardware/usb_interface/test.kicad_pcb (2022-03-08)

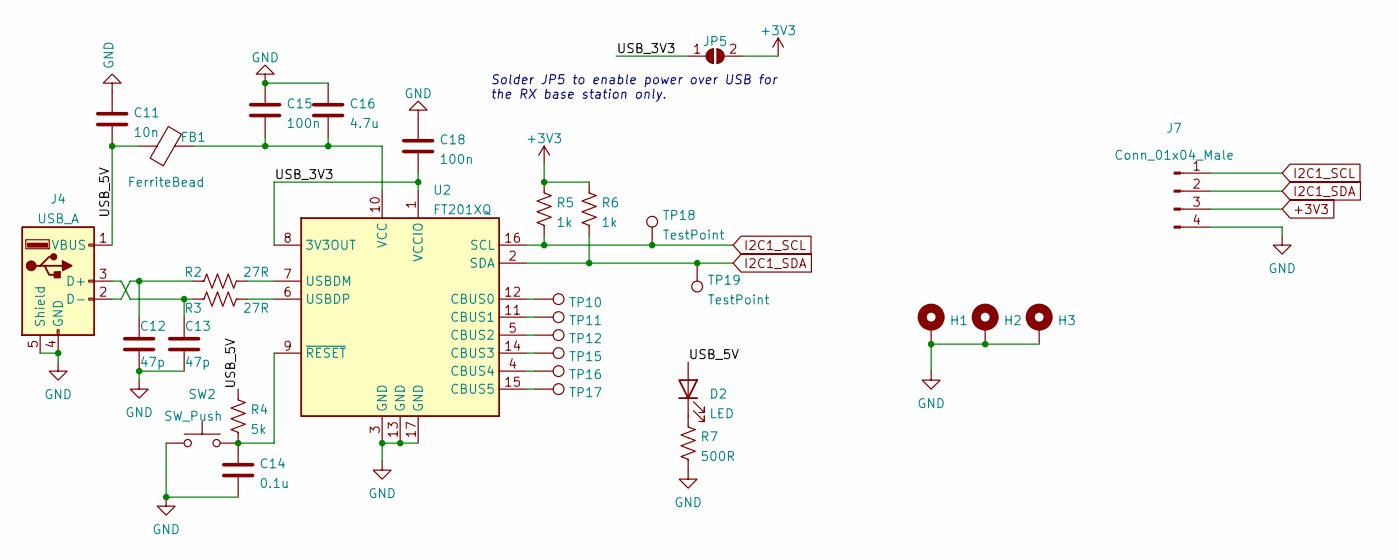
[picture p113: schematic test.kicad_sch]

Parts:
C11: 10n; C_0603_1608Metric
C12, C13: 47p; C_0603_1608Metric
C14: 0.1u; C_0603_1608Metric
C15, C18: 100n; C_0603_1608Metric
C16: 4.7u; C_0603_1608Metric
D2: LED; LED_0805_2012Metric
FB1: FerriteBead; LED_0805_2012Metric
H1, H2, H3: MountingHole_Pad; MountingHole_2.2mm_M2_Pad_Via
J4: USB_A; USB_A_Molex_67643_Horizontal
J7: Conn_01x04_Male; PinHeader_1x04_P1.27mm_Vertical
JP5: SolderJumper_2_Open; SolderJumper-2_P1.3mm_Open_RoundedPad1.0x1.5mm
R2, R3: 27R; R_0805_2012Metric_Pad1.20x1.40mm_HandSolder
R4: 5k; R_0805_2012Metric_Pad1.20x1.40mm_HandSolder
R5, R6: 1k; R_0805_2012Metric_Pad1.20x1.40mm_HandSolder
R7: 500R; R_0805_2012Metric_Pad1.20x1.40mm_HandSolder
SW2: SW_Push; PinSocket_1x02_P2.54mm_Vertical
TP10, TP11, TP12, TP15, TP16, TP17, TP18, TP19: TestPoint; TestPoint_Pad_1.0x1.0mm
U2: FT201XQ; QFN-16-1EP_4x4mm_P0.65mm_EP2.1x2.1mm

Connections:
+3V3: J7.3, JP5.2 (B), R5.1, R6.1
/USB_3V3: C18.2, JP5.1 (A), U2.1 (VCCIO), U2.8 (3V3OUT)
/USB_5V: C11.2, D2.2 (A), FB1.1, J4.1 (VBUS), R4.1
GND: C11.1, C12.2, C13.2, C14.2, C15.1, C16.1, C18.1, H1.1, H2.1, H3.1, J4.4 (GND), J4.5 (Shield), J7.4, R7.2, SW2.1, U2.3 (GND), U2.13 (GND), U2.17 (GND)
I2C1_SCL: J7.1, R5.2, TP18.1, U2.16 (SCL)
I2C1_SDA: J7.2, R6.2, TP19.1, U2.2 (SDA)
unnamed: C15.2, C16.2, FB1.2, U2.10 (VCC)
unnamed: C12.1, J4.2 (D-), R2.1
unnamed: C13.1, J4.3 (D+), R3.1
unnamed: D2.1 (K), R7.1
unnamed: TP16.1, U2.4 (CBUS4)
unnamed: TP12.1, U2.5 (CBUS2)
unnamed: R3.2, U2.6 (USBDP)
unnamed: R2.2, U2.7 (USBDM)
unnamed: C14.1, R4.2, SW2.2, U2.9 (~RESET)
unnamed: TP11.1, U2.11 (CBUS1)
unnamed: TP10.1, U2.12 (CBUS0)
unnamed: TP15.1, U2.14 (CBUS3)
unnamed: TP17.1, U2.15 (CBUS5)

Notes on the sheet:
Solder JP5 to enable power over USB for the RX base station only.

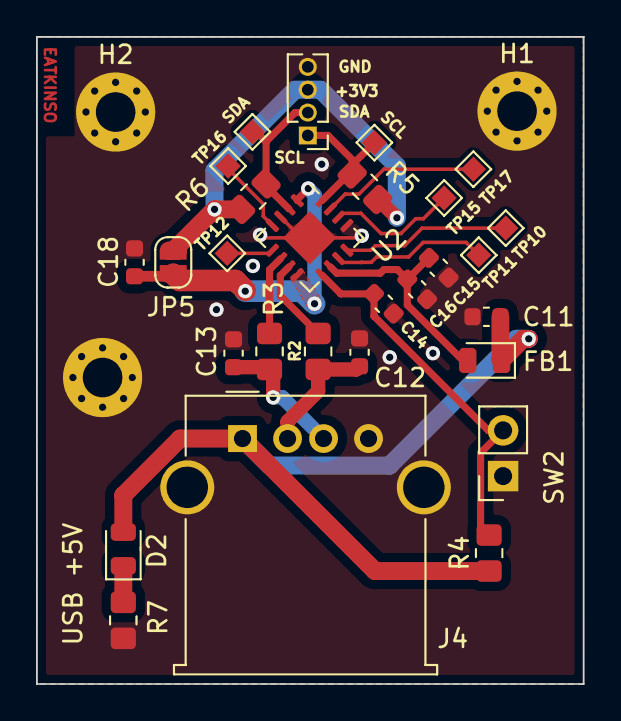
[picture p114: board test.kicad_pcb from above]

Board: 2 copper layers, 30.4 x 35.9 mm, 31 parts (0 on the bottom side), 19 nets.
