eatkinso/bike-anti-theft-device/Hardware/bike_alarm/bike_alarm.kicad_pcb

## KiCad design Hardware/bike_alarm/bike_alarm.kicad_pcb (2022-03-07)

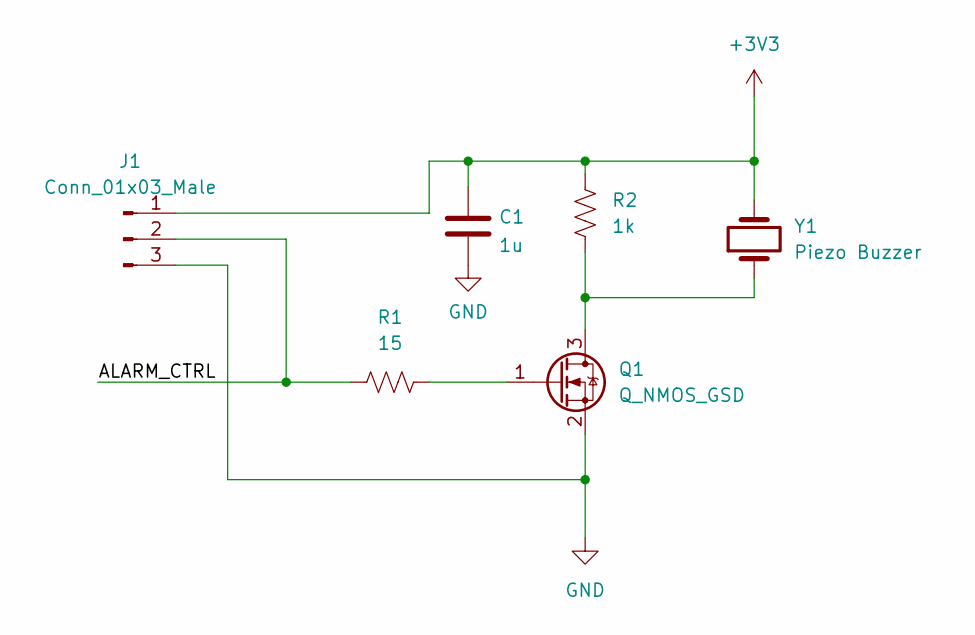
[picture p115: schematic bike_alarm.kicad_sch]

Parts:
C1: 1u; C_0805_2012Metric
J1: Conn_01x03_Male; PinHeader_1x03_P2.54mm_Vertical
Q1: Q_NMOS_GSD; SOT-23
R1: 15; R_0805_2012Metric_Pad1.20x1.40mm_HandSolder
R2: 1k; R_0805_2012Metric_Pad1.20x1.40mm_HandSolder
Y1: Piezo Buzzer; Crystal_AT310_D3.0mm_L10.0mm_Horizontal

Connections:
+3V3: C1.1, J1.1, R2.1, Y1.2
/ALARM_CTRL: J1.2, R1.1
GND: C1.2, J1.3, Q1.2 (S)
unnamed: Q1.1 (G), R1.2
unnamed: Q1.3 (D), R2.2, Y1.1

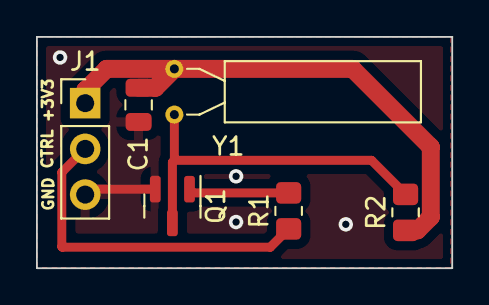
[picture p116: board bike_alarm.kicad_pcb from above]

Board: 2 copper layers, 23.1 x 12.9 mm, 6 parts (0 on the bottom side), 5 nets.
