eatkinso/bike-anti-theft-device/Hardware/RFID_board/RFID_board.kicad_pcb

## KiCad design Hardware/RFID_board/RFID_board.kicad_pcb (2022-03-07)

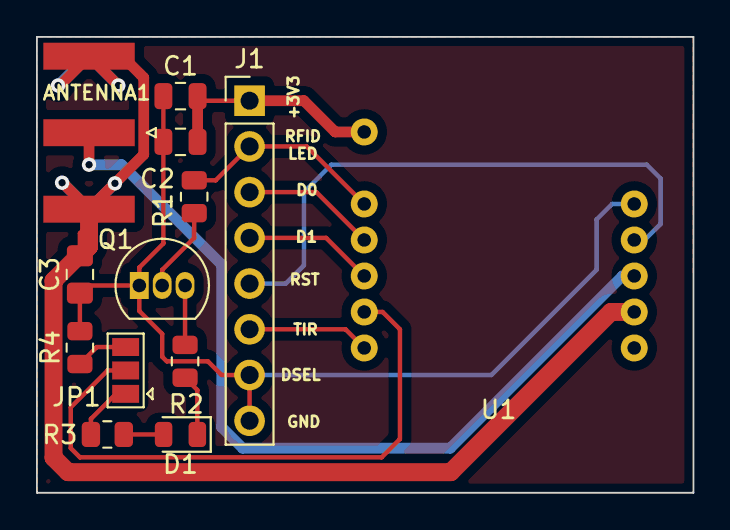
[picture p117: board RFID_board.kicad_pcb from above]

Board: 2 copper layers, 36.5 x 25.3 mm, 13 parts (0 on the bottom side), 16 nets.

Parts:
ANTENNA1: 1.337m; SMA_Amphenol_132289_EdgeMount
C1: 10n; C_0805_2012Metric
C2: 1u; C_0805_2012Metric
C3: DNP; C_0805_2012Metric_Pad1.18x1.45mm_HandSolder
D1: LED; D_0805_2012Metric
J1: Conn_01x08_Male; PinHeader_1x08_P2.54mm_Vertical
JP1: SolderJumper_3_Open; SolderJumper-3_P1.3mm_Open_Pad1.0x1.5mm
Q1: 2N3904; TO-92_Inline
R1: 15R; R_0805_2012Metric
R2: 300R; R_0805_2012Metric
R3, R4: 1k; R_0805_2012Metric
U1: ID-3LA

Connections:
+3V3: D1.2 (A), R3.1
+3V3_RFID: C1.2, C2.2, J1.1, U1.11 (VCC)
GND: C1.1, C2.1, C3.1, J1.7, J1.8, Q1.1 (E), R4.2, U1.1 (GND)
unnamed: ANTENNA1.1, U1.3 (ANT)
unnamed: ANTENNA1.2, C3.2, U1.4 (ANT)
unnamed: D1.1 (K), R2.1
unnamed: J1.3, U1.9 (DATA0)
unnamed: J1.4, U1.8 (DATA1)
unnamed: J1.5, U1.2 (RST)
unnamed: J1.6, U1.6 (TAG_IN_RANGE)
unnamed: JP1.1 (A), R3.2
unnamed: JP1.2 (C), U1.7 (DATA_SELECT)
unnamed: JP1.3 (B), R4.1
unnamed: Q1.2 (B), R1.2
unnamed: Q1.3 (C), R2.2
RFID_LED: J1.2, R1.1, U1.10 (LED)
