eatkinso/bike-anti-theft-device/Firmware/SingleCore_UART/Core/Src/main.c

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
/* Includes ------------------------------------------------------------------*/
#include "main.h"

/* USER CODE BEGIN Includes */
#include "btrfid.h"
#include "btgps.h"
#include <stdint.h>
/* USER CODE END Includes */

 ADC_HandleTypeDef hadc;

UART_HandleTypeDef hlpuart1;
UART_HandleTypeDef huart1;

TIM_HandleTypeDef htim1;
TIM_HandleTypeDef htim2;

void SystemClock_Config(void);
static void MX_GPIO_Init(void);
static void MX_USART1_UART_Init(void);
static void MX_ADC_Init(void);
static void MX_LPUART1_UART_Init(void);
static void MX_TIM1_Init(void);
static void MX_TIM2_Init(void);
/* USER CODE BEGIN 0 */
uint8_t gps_buffer[100] = {0};
uint8_t dma_buffer[100] = {0};
uint8_t rxdata[90]= {0};
uint8_t testrxdata[90] = {0};
nmea_gpgga_t cur_gpsmsgbuf;
nmea_gpgga_t prev_gpsmgsbuf;
uint8_t rawbuf[24]={0};
uint8_t rfidbuf[13]={0};
uint8_t rfiddummydata[13]={0x3f,0xa6,0xe6,0xe6,0xe6,0x26,0x26,0xa9,0xf9,0x2e,0xca,0xd6,0xf2
};
statemachine_state_t mystate;
volatile uint8_t rfidrawbuf[50]={0};
volatile uint8_t rfidmsgbuf[15]={0};
uint32_t rfidstarttime;
/* USER CODE END 0 */

/**
  * @brief  The application entry point.
  * @retval int
  */
int main(void)
{
  /* USER CODE BEGIN 1 */
	mystate=BT_IDLE;
  /* USER CODE END 1 */

  /* MCU Configuration--------------------------------------------------------*/

  /* Reset of all peripherals, Initializes the Flash interface and the Systick. */
  HAL_Init();

  /* Configure the system clock */
  SystemClock_Config();

  /* Initialize all configured peripherals */
  MX_GPIO_Init();
  MX_USART1_UART_Init();
  MX_ADC_Init();
  MX_LPUART1_UART_Init();
  MX_TIM1_Init();
  MX_TIM2_Init();
  /* USER CODE BEGIN 2 */
  HAL_GPIO_WritePin(IDLE_GPIO_Port, IDLE_Pin, GPIO_PIN_SET);
  HAL_GPIO_WritePin(IDLE_GPIO_Port, IDLE_Pin, GPIO_PIN_RESET);
  HAL_GPIO_WritePin(UNLOCKED_GPIO_Port, UNLOCKED_Pin, GPIO_PIN_SET);
  HAL_GPIO_WritePin(UNLOCKED_GPIO_Port, UNLOCKED_Pin, GPIO_PIN_RESET);
  HAL_GPIO_WritePin(TRANSIT_GPIO_Port, TRANSIT_Pin, GPIO_PIN_SET);
  HAL_GPIO_WritePin(TRANSIT_GPIO_Port, TRANSIT_Pin, GPIO_PIN_RESET);
  HAL_GPIO_WritePin(ALARM_GPIO_Port, ALARM_Pin, GPIO_PIN_SET);
  HAL_GPIO_WritePin(ALARM_GPIO_Port, ALARM_Pin, GPIO_PIN_RESET);
  HAL_GPIO_WritePin(GET_GPS_GPIO_Port, GET_GPS_Pin, GPIO_PIN_SET);
  HAL_GPIO_WritePin(GET_GPS_GPIO_Port, GET_GPS_Pin, GPIO_PIN_RESET);
  HAL_TIM_Base_Start(&htim2);
  /* USER CODE END 2 */

  /* Infinite loop */
  /* USER CODE BEGIN WHILE */
  nmea_gpgga_t testgps1 = {"170921.000","4006.9306",'N',"08813.6236",'W','1','7'};
  nmea_gpgga_t testgps2 = {"170921.000","4006.9135",'N',"08813.6236",'W','1','7'};
  // GPS counter -- poll GPS once every 30 seconds 
  volatile int prevgetgpstime=0;
  volatile int getgpstime=0;
  nmea_gpgga_t gpsbuf1={0};
  nmea_gpgga_t gpsbuf2={0};
 // volatile uint32_t distbuffer[10] = {0};
  volatile uint32_t latest_dist=0;
  volatile uint32_t full_dist=0;
  int threshold = 8;
  volatile int tcounter;
  while (1)
  { 
    getgpstime = __HAL_TIM_GET_COUNTER(&htim2);
    if ((getgpstime - prevgetgpstime)>10000){
      HAL_GPIO_WritePin(GET_GPS_GPIO_Port, GET_GPS_Pin, GPIO_PIN_SET);
      prev_gpsmgsbuf = cur_gpsmsgbuf;
      get_gps(&huart1, &cur_gpsmsgbuf);
      latest_dist = getdistance(&prev_gpsmgsbuf.latitude, &prev_gpsmgsbuf.longitude, &cur_gpsmsgbuf.latitude, &cur_gpsmsgbuf.longitude);
      prevgetgpstime=getgpstime;
      HAL_Delay(1000);
      HAL_GPIO_WritePin(GET_GPS_GPIO_Port, GET_GPS_Pin, GPIO_PIN_RESET);
    }
    
   /*
    for (int i = 0; i <10; i ++){
      get_gps(&huart1, &gpsbuf1);
      get_gps(&huart1, &gpsbuf2);
      latest_dist=getdistance(&gpsbuf1.latitude, &gpsbuf1.longitude, &gpsbuf2.latitude, &gpsbuf2.longitude);
    }*/
    
    // test GPS stuff: 
    //uint32_t full_dist = getdistance(&testgps1.latitude, &testgps1.longitude, &testgps2.latitude, &testgps2.longitude);
    /* USER CODE END WHILE */

    /* USER CODE BEGIN 3 */
    switch (mystate){
	  case BT_IDLE	:
		  HAL_GPIO_WritePin(IDLE_GPIO_Port, IDLE_Pin, GPIO_PIN_SET);
		  HAL_GPIO_WritePin(UNLOCKED_GPIO_Port, UNLOCKED_Pin, GPIO_PIN_RESET);
		  HAL_GPIO_WritePin(TRANSIT_GPIO_Port, TRANSIT_Pin, GPIO_PIN_RESET);
		  HAL_GPIO_WritePin(ALARM_GPIO_Port, ALARM_Pin, GPIO_PIN_RESET);
      // state transition for idle->unlocked is in the LPUART IRQ
		  HAL_StatusTypeDef res = HAL_UART_Receive_IT(&hlpuart1,rfidrawbuf,40);
		  if (latest_dist>threshold){
        mystate=BT_ALARM;
      }

		  break;
	  case BT_UNLOCKED	:
		  HAL_GPIO_WritePin(IDLE_GPIO_Port, IDLE_Pin, GPIO_PIN_RESET);
		  HAL_GPIO_WritePin(UNLOCKED_GPIO_Port, UNLOCKED_Pin, GPIO_PIN_SET);
		  HAL_GPIO_WritePin(TRANSIT_GPIO_Port, TRANSIT_Pin, GPIO_PIN_RESET);
		  HAL_GPIO_WritePin(ALARM_GPIO_Port, ALARM_Pin, GPIO_PIN_RESET);
      int unlocked_time = __HAL_TIM_GET_COUNTER(&htim2);
      if (((unlocked_time - rfidstarttime) > 5000)){
        mystate=BT_IDLE;
      }
      if (latest_dist>5){
        mystate=BT_TRANSIT;
        tcounter = 0;
      }
		  break;
	  case BT_TRANSIT	:
		  HAL_GPIO_WritePin(IDLE_GPIO_Port, IDLE_Pin, GPIO_PIN_RESET);
		  HAL_GPIO_WritePin(UNLOCKED_GPIO_Port, UNLOCKED_Pin, GPIO_PIN_RESET);
		  HAL_GPIO_WritePin(TRANSIT_GPIO_Port, TRANSIT_Pin, GPIO_PIN_SET);
		  HAL_GPIO_WritePin(ALARM_GPIO_Port, ALARM_Pin, GPIO_PIN_RESET);
      if (latest_dist<5){
        tcounter = tcounter +1;
        if (tcounter > 4){
        mystate=BT_IDLE;
        tcounter =0;
        latest_dist=0;
        }
      }
		  break;
	  case BT_ALARM:
		  HAL_GPIO_WritePin(IDLE_GPIO_Port, IDLE_Pin, GPIO_PIN_RESET);
		  HAL_GPIO_WritePin(UNLOCKED_GPIO_Port, UNLOCKED_Pin, GPIO_PIN_RESET);
		  HAL_GPIO_WritePin(TRANSIT_GPIO_Port, TRANSIT_Pin, GPIO_PIN_RESET);
		  HAL_GPIO_WritePin(ALARM_GPIO_Port, ALARM_Pin, GPIO_PIN_SET);
      HAL_TIM_PWM_Start(&htim1, TIM_CHANNEL_4);
      HAL_Delay(1000);
      HAL_TIM_PWM_Stop(&htim1, TIM_CHANNEL_4);
      latest_dist=0;
      mystate=BT_IDLE;
	  }
  }
  /* USER CODE END 3 */
}

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
