eatkinso/bike-anti-theft-device/Firmware/UART_nucleo/Core/Inc/main.h

#define LED1_Pin GPIO_PIN_15
#define LED1_GPIO_Port GPIOB
#define TRANSIT_Pin GPIO_PIN_11
#define TRANSIT_GPIO_Port GPIOA
#define IDLE_Pin GPIO_PIN_4
#define IDLE_GPIO_Port GPIOB
#define LED2_Pin GPIO_PIN_9
#define LED2_GPIO_Port GPIOB
#define UNLOCKED_Pin GPIO_PIN_5
#define UNLOCKED_GPIO_Port GPIOB
#define FE_CTRL3_Pin GPIO_PIN_3
#define FE_CTRL3_GPIO_Port GPIOC
#define B1_Pin GPIO_PIN_0
#define B1_GPIO_Port GPIOA
#define FE_CTRL2_Pin GPIO_PIN_5
#define FE_CTRL2_GPIO_Port GPIOC
#define ALARM_Pin GPIO_PIN_9
#define ALARM_GPIO_Port GPIOA
#define FE_CTRL1_Pin GPIO_PIN_4
#define FE_CTRL1_GPIO_Port GPIOC
#define B3_Pin GPIO_PIN_6
#define B3_GPIO_Port GPIOC
#define B2_Pin GPIO_PIN_1
#define B2_GPIO_Port GPIOA
#define LED3_Pin GPIO_PIN_11
#define LED3_GPIO_Port GPIOB
#define T_VCP_RX_Pin GPIO_PIN_3
#define T_VCP_RX_GPIO_Port GPIOA
#define T_VCP_RXA2_Pin GPIO_PIN_2
#define T_VCP_RXA2_GPIO_Port GPIOA
