eatkinso/bike-anti-theft-device/Firmware/stm32wl_fwpackage/STM32Cube_FW_WL_V1.2.0/Projects/NUCLEO-WL55JC/Demonstrations/LocalNetwork/LocalNetwork_Sensor/Core/Src/main.c

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
/* Includes ------------------------------------------------------------------*/
#include "gpio.h"
#include "sys_app.h"
#include "demo_sensor.h"
#include "version.h"
#include "stm32_seq.h"
#include "stm32_timer.h"
#include "adc_if.h"

/* USER CODE BEGIN PD */
#define SENS_LED_BLINK 1
/* USER CODE END PD */


/* USER CODE BEGIN PV */

UTIL_TIMER_Object_t LedTimer;        /**<Timer which turns LEDs off*/

/* USER CODE END PV */

void SystemClock_Config(void);
/* USER CODE BEGIN PFP */
/**
 * @brief Turn all LEDs off.
 * Used as a timer callback.
 */
static void LedsOff(void* context);

/**
 * @brief Do a short blink with a LED.
 */
static void LedBlink(void);

/**
 * @brief Callback to write sensor data right before transmission.
 */
static void WriteDataCallback(void);
/* USER CODE END PFP */

/**
  * @brief  The application entry point.
  * @retval int
  */
int main(void)
{
  /* MCU Configuration--------------------------------------------------------*/

  /* Reset of all peripherals, Initializes the Flash interface and the Systick. */
  HAL_Init();

  /* Configure the system clock */
  SystemClock_Config();

  /* Initialize all configured peripherals */
  MX_GPIO_Init();
  /* USER CODE BEGIN 2 */
  SystemApp_Init();

  UTIL_TIMER_Create(&LedTimer, 125, UTIL_TIMER_ONESHOT, LedsOff, NULL);

  /************************************************
   *
   *             Sensor
   *
   ************************************************/

  APP_LOG(TS_OFF, VLEVEL_L,
          "--------------------------\r\n"
          "    Sensor Reset\r\n"
          "     %s\r\n"
          "--------------------------\r\n", VERSION_STR);
#if 0
  /*Init meters*/
  if(Meters_Init() != 0)
  {
    APP_LOG(TS_ON, VLEVEL_L, "Cannot init sensor!\r\n");
  }
#endif
  /*Put error data to be sent before first measurement*/

  /*Init sensor stuff and start scanning for beacon*/
  SENS_Init(WriteDataCallback, LedBlink);

  /* USER CODE END 2 */

  /* Infinite loop */
  /* USER CODE BEGIN WHILE */
  while (1)
  {
    /* USER CODE END WHILE */
    UTIL_SEQ_Run( UTIL_SEQ_DEFAULT );

    /* USER CODE BEGIN 3 */
  }
  /* USER CODE END 3 */
}

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
/* USER CODE BEGIN 4 */
/**
 * @brief Callback to write sensor data right before transmission.
 */

static DEMO_data_1_0_t data =
  {
      .temperature      = DEMO_DATA_1_0_ERROR_TEMPERATURE,
      .voltage          = DEMO_DATA_1_0_ERROR_VOLTAGE,
  };

static void WriteDataCallback(void)
{
  data.voltage=SYS_GetBatteryLevel()/50;
  data.temperature=(SYS_GetTemperatureLevel()*100)>>8;

  SENS_WriteSensorData(&data);
}

/**
 * @brief Turn all LEDs off.
 * Used as a timer callback.
 */
static void LedsOff(void* context)
{
  UNUSED(context);

#if SENS_LED_BLINK != 0
  HAL_GPIO_WritePin(LED1_GPIO_Port, LED1_Pin, GPIO_PIN_RESET); /* LED_BLUE */
  HAL_GPIO_WritePin(LED2_GPIO_Port, LED2_Pin, GPIO_PIN_RESET); /* LED_GREEN */
  HAL_GPIO_WritePin(LED3_GPIO_Port, LED3_Pin, GPIO_PIN_RESET); /* LED_RED */
#endif /*SENS_LED_BLINK*/
}

/**
 * @brief Do a short blink with a LED.
 */
static void LedBlink(void)
{
#if SENS_LED_BLINK != 0
  if(UTIL_TIMER_IsRunning(&LedTimer))    /*Timer is already running, LED flashing is too fast*/
  {
    switch(SENS_GetState())
    {
      case SENS_STATE_Connect:
        HAL_GPIO_TogglePin(LED2_GPIO_Port, LED2_Pin); /* LED_GREEN */
        HAL_GPIO_WritePin(LED3_GPIO_Port, LED3_Pin, GPIO_PIN_RESET); /* LED_RED */
        HAL_GPIO_WritePin(LED1_GPIO_Port, LED1_Pin, GPIO_PIN_RESET); /* LED_BLUE */
        break;
      case SENS_STATE_Lost:
        HAL_GPIO_TogglePin(LED3_GPIO_Port, LED3_Pin); /* LED_RED */
        HAL_GPIO_WritePin(LED2_GPIO_Port, LED2_Pin, GPIO_PIN_RESET); /* LED_GREEN */
        HAL_GPIO_WritePin(LED1_GPIO_Port, LED1_Pin, GPIO_PIN_RESET); /* LED_BLUE */
        break;
      case SENS_STATE_Scan:
        HAL_GPIO_TogglePin(LED3_GPIO_Port, LED3_Pin); /* LED_RED */
        HAL_GPIO_WritePin(LED2_GPIO_Port, LED2_Pin, GPIO_PIN_RESET); /* LED_GREEN */
        HAL_GPIO_WritePin(LED1_GPIO_Port, LED1_Pin, GPIO_PIN_RESET); /* LED_BLUE */
        break;
      case SENS_STATE_Sync:
        HAL_GPIO_TogglePin(LED1_GPIO_Port, LED1_Pin); /* LED_BLUE */
        HAL_GPIO_WritePin(LED3_GPIO_Port, LED3_Pin, GPIO_PIN_RESET); /* LED_RED */
        HAL_GPIO_WritePin(LED2_GPIO_Port, LED2_Pin, GPIO_PIN_RESET); /* LED_GREEN */
        break;
      default: break;
    }
    UTIL_TIMER_Stop(&LedTimer);
    UTIL_TIMER_Start(&LedTimer);
  }
  else
  {
    switch(SENS_GetState())
    {
      case SENS_STATE_Connect:
        HAL_GPIO_WritePin(LED2_GPIO_Port, LED2_Pin, GPIO_PIN_SET); /* LED_GREEN */
        break;
      case SENS_STATE_Lost:
        HAL_GPIO_WritePin(LED3_GPIO_Port, LED3_Pin, GPIO_PIN_SET); /* LED_RED */
        break;
      case SENS_STATE_Scan:
        HAL_GPIO_WritePin(LED3_GPIO_Port, LED3_Pin, GPIO_PIN_SET); /* LED_RED */
        break;
      case SENS_STATE_Sync:
        HAL_GPIO_WritePin(LED1_GPIO_Port, LED1_Pin, GPIO_PIN_SET); /* LED_BLUE */
        break;
      default: break;
    }
    UTIL_TIMER_Start(&LedTimer);
  }
#endif /*SENS_LED_BLINK*/
}
/* USER CODE END 4 */
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
