eatkinso/bike-anti-theft-device/Firmware/ST/STM32Cube_FW_WL_V1.1.0/Projects/NUCLEO-WL55JC/Templates_LL/SingleCore/Inc/main.h

#define LED1_PIN                               LL_GPIO_PIN_8
#define LED1_GPIO_PORT                         GPIOB
#define LED2_PIN                               LL_GPIO_PIN_9
#define LED2_GPIO_PORT                         GPIOB
#define LED3_PIN                               LL_GPIO_PIN_15
#define LED3_GPIO_PORT                         GPIOB
#define BUTTON_SW1_PIN                         LL_GPIO_PIN_0
#define BUTTON_SW1_GPIO_PORT                   GPIOA
#define BUTTON_SW1_GPIO_PUPD                   LL_GPIO_PULL_UP
#define BUTTON_SW1_EXTI_LINE                   LL_EXTI_LINE_0
#define BUTTON_SW1_EXTI_IRQn                   EXTI0_IRQn
#define BUTTON_SW1_IRQHANDLER                  EXTI0_IRQHandler
#define BUTTON_SW2_PIN                         LL_GPIO_PIN_1
#define BUTTON_SW2_GPIO_PORT                   GPIOA
#define BUTTON_SW1_GPIO_PUPD                   LL_GPIO_PULL_UP
#define BUTTON_SW2_EXTI_LINE                   LL_EXTI_LINE_1
#define BUTTON_SW2_EXTI_IRQn                   EXTI1_IRQn
#define BUTTON_SW2_IRQHANDLER                  EXTI1_IRQHandler
#define BUTTON_SW3_PIN                         LL_GPIO_PIN_3
#define BUTTON_SW3_GPIO_PORT                   GPIOC
#define BUTTON_SW1_GPIO_PUPD                   LL_GPIO_PULL_UP
#define BUTTON_SW3_EXTI_LINE                   LL_EXTI_LINE_3
#define BUTTON_SW3_EXTI_IRQn                   EXTI3_IRQn
#define BUTTON_SW3_IRQHANDLER                  EXTI3_IRQHandler
#define NVIC_PRIORITYGROUP_0         ((uint32_t)0x00000007) /*!< 0 bit  for pre-emption priority,
#define NVIC_PRIORITYGROUP_1         ((uint32_t)0x00000006) /*!< 1 bit  for pre-emption priority,
#define NVIC_PRIORITYGROUP_2         ((uint32_t)0x00000005) /*!< 2 bits for pre-emption priority,
#define NVIC_PRIORITYGROUP_3         ((uint32_t)0x00000004) /*!< 3 bits for pre-emption priority,
#define NVIC_PRIORITYGROUP_4         ((uint32_t)0x00000003) /*!< 4 bits for pre-emption priority,
