eatkinso/bike-anti-theft-device/(commit log)

2022-02-17 latest notebook entry
    [alarm.kicad_pcb, alarm.kicad_sch]
2022-02-20 main board work, docs, stm32cubemx files
    [BOM_full.xlsx, alarm.kicad_pcb, alarm.kicad_sch, main_board.kicad_pcb, main_board.kicad_sch]
2022-02-21 more main pcb work (changed pinout, added USB interface), additional reference docs
    [MB1720.PcbLib, STM32WL_UFQFPN48_Ref_Board.SchDoc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]
2022-02-22 add bike alarm
    [bike_alarm.kicad_pcb, bike_alarm.kicad_sch]
2022-03-04 split schematic into separate board
    [RFID_board.kicad_pcb, RFID_board.kicad_sch, main_board-old.kicad_pcb, main_board.kicad_pcb, main_board.kicad_sch]
2022-03-06 bike_alarm pcb update and bom
    [bike_alarm.csv, bike_alarm.kicad_pcb, bike_alarm.kicad_sch, bike_alarm_materials.xlsx]
2022-03-06 update bom
    [bike_alarm_materials.xlsx]
2022-03-06 finished rfid pcb
    [RFID_board.kicad_pcb]
2022-03-07 finished main board
    [main_board.kicad_pcb]
2022-03-07 all boards pass DRC and have appropriate silkscreens, will order tomorrow
    [RFID_board.kicad_pcb, bike_alarm.kicad_pcb, bike_alarm.kicad_sch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]
2022-03-08 usb interface
    [test-B_Cu.gbr, test-B_Mask.gbr, test-B_Paste.gbr, test-B_Silkscreen.gbr, test-Edge_Cuts.gbr, test-F_Cu.gbr, test-F_Mask.gbr, test-F_Paste.gbr]
2022-04-12 safety commit
    [main_board_bodged-B_Cu.gbr, main_board_bodged-B_Mask.gbr, main_board_bodged-B_Paste.gbr, main_board_bodged-B_Silkscreen.gbr, main_board_bodged-Edge_Cuts.gbr, main_board_bodged-F_Cu.gbr, main_board_bodged-F_Mask.gbr, main_board_bodged-F_Paste.gbr]
2022-04-12 mostly notes
    [main_board_bodged.kicad_sch]
2022-04-13 more notes etc
    [RFID_board-B_Cu.gbr, RFID_board-B_Mask.gbr, RFID_board-B_Paste.gbr, RFID_board-B_Silkscreen.gbr, RFID_board-Edge_Cuts.gbr, RFID_board-F_Cu.gbr, RFID_board-F_Mask.gbr, RFID_board-F_Paste.gbr]
2022-04-14 lora helper functions
    [main_board_bodged.kicad_sch]
2022-04-19 safety commit, uart working kinda
    [main_board_bodged.kicad_sch]
2022-04-22 dummy nucleo uart device for python gui backend development
