eatkinso/bike-anti-theft-device/(notices)

Notices in the files:
Firmware/SingleCore_UART/Core/Src/main.c:
© Copyright (c) 2022 STMicroelectronics.
All rights reserved.
Firmware/stm32wl_fwpackage/STM32Cube_FW_WL_V1.2.0/Projects/NUCLEO-WL55JC/Demonstrations/LocalNetwork/LocalNetwork_Sensor/Core/Src/main.c:
Copyright (c) 2021 STMicroelectronics.
This software is licensed under terms that can be found in the LICENSE file
Firmware/UART_nucleo/Core/Inc/main.h:
Copyright (c) 2022 STMicroelectronics.
